SEDS-PSU/avionics/README.md

# Avionics

## /electronics
Board files and etc for avionics and teststand electronics
