SEDS-PSU/avionics/FD-Q10C.png

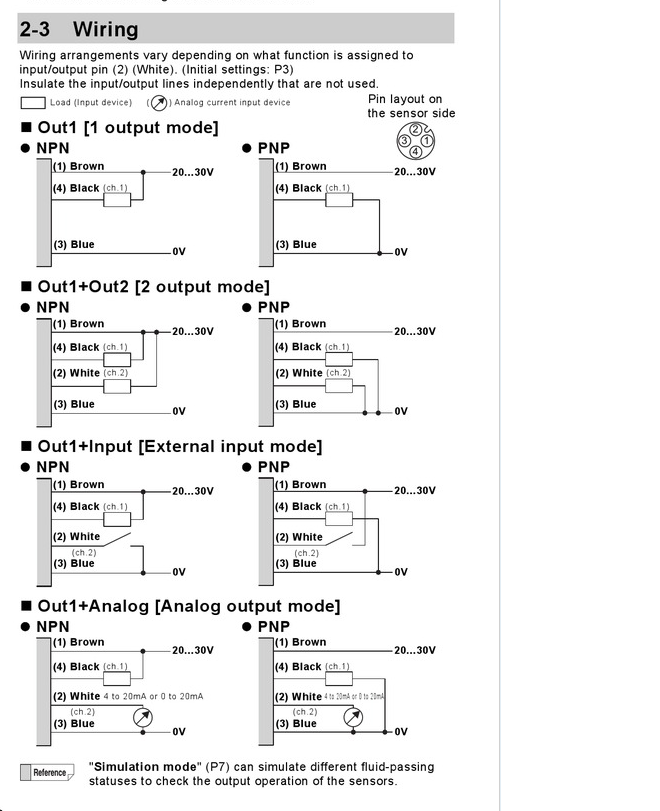
FD-Q10C.png
