SEDS-PSU/avionics/electronics/output-board/output-board BOM.xlsx

Id | Designator | Package | Quantity | Designation | Supplier and ref | Column1 | _1
1 | D1,D12,D11,D6,D7,D8,D3,D2,D5,D13,D4,D9,D10 | LED_1206_3216Metric | 13 | LED
2 | MOSFET5,MOSFET13,MOSFET18,MOSFET8,MOSFET1,MOSFET11,MOSFET2,MOSFET12,MOSFET4,MOSFET7,MOSFET9,MOSFET6,MOSFET3 | BSS806NEH6327XTSA1 | 13 | BSS806NEH6327XTSA1
3 | R5,R7,R10,R9,R4,R6,R26,R8,R20,R2,R30,R31,R28,R11 | R_0603_1608Metric | 14 | 511
4 | J8,J13,J11,J2,J7,J9,J10,J16,J15,J17,J12,J1,J18 | LatchingConnector2POS | 13 | Conn_01x02_Male
5 | C3,C1 | C_0603_1608Metric | 2 | 1uF
6 | R3 | R_0603_1608Metric | 1 | 0k
7 | Ref** | seds-logo | 1 | Val**
8 | C5,C9,C4,C6,C8,C13,C7,C12 | C_0603_1608Metric | 8 | 100nF
9 | U2 | SOT-23-5 | 1 | LD3985M33R_SOT23
10 | J6,J4 | LatchingConnector2POS | 2 | Conn_01x02
11 | J20 | LatchingConnector2POS | 1 | Ignition Detector
12 | C11,C10 | C_0603_1608Metric | 2 | 20pF
13 | Y1 | Crystal_SMD_3225-4Pin_3.2x2.5mm | 1 | 25MHz 9pF
14 | R19,R12,R21,R23,R27,R18,R29,R14,R25,R22,R16,R24,R17,R15 | R_0603_1608Metric | 14 | 1K
15 | J19 | PinHeader_2x03_P2.54mm_Vertical | 1 | Extra IO
16 | L1 | L_0603_1608Metric | 1 | 10uH
17 | SW1 | Button CS1102 | 1 | SW_Push_Dual
18 | C2 | C_0603_1608Metric | 1 | 10nF
19 | U3 | LFBGA-100_10x10mm_Layout10x10_P0.8mm | 1 | STM32F105VBH6
20 | D15 | LED_1206_3216Metric | 1 | 5V
21 | R13 | R_0603_1608Metric | 1 | 10K
22 | J14 | LatchingConnector2POS | 1 | Arming switch
23 | J3 | PowerPoleThroughHole | 1 | 12V In
24 | R32 | R_0603_1608Metric | 1 | 220
25 | MOSFET10 | BUK9Y21-40E | 1 | BUK9Y21-40E
26 | D14 | LED_1206_3216Metric | 1 | 12V
27 | U1 | MAX33012EASA+ | 1 | MAX33012EASA+
28 | R1 | R_0603_1608Metric | 1 | 10k
29 | J5 | PinHeader_1x04_P2.54mm_Vertical | 1 | SWD Header
