SEDS-PSU/avionics/electronics/datasheets/sensor-board/sensor-board BOM.xlsx

Sheet: BOM
 | Footprint | Quantity | Name
x | Button CS1102 | 1 | SW_Push_Dual |  | passive components are named with their value
 | C_0603_1608Metric | 14 | 0.1uF
 | C_0603_1608Metric | 8 | 100nF
 | C_0603_1608Metric | 1 | 10nF
 | C_0603_1608Metric | 2 | 1uF
 | C_0603_1608Metric | 2 | 20pF
 | Crystal_SMD_3225-4Pin_3.2x2.5mm | 1 | Crystal_GND24
only 1 f. | K_type_thermo_conn_F | 7 | Thermocouple PCB connector | https://evosensors.com/collections/miniature-pcb-flat-mounting/products/k1x-femx-con-fp-x-pccx
 | L_0603_1608Metric | 1 | 10uH
 | MAX33012EASA+ | 1 | 21-0041-3-M_90-0096-8L_MXM
 | 14 SO (14 pin) | 1 | MAX44252ASD
only 1 f. | MCP96RL01T_QFN | 7 | MCP96RL01T
 | PinHeader_1x04_P2.54mm_Vertical | 1 | SWD Header
order | PowerPoleThroughHole | 2 | Power Pole Connector
 | R_0603_1608Metric | 1 | 0k
 | R_0603_1608Metric | 20 | 100
 | R_0603_1608Metric | 7 | 10k
 | R_0603_1608Metric | 1 | 13k
 | R_0603_1608Metric | 22 | 150
 | R_0603_1608Metric | 7 | 1M
 | R_0603_1608Metric | 1 | 2.2k
 | R_0603_1608Metric | 1 | 22k
 | R_0603_1608Metric | 4 | 24.92
 | R_0603_1608Metric | 14 | 2M
 | R_0603_1608Metric | 1 | 4.3k
 | R_0603_1608Metric | 2 | 4.7k
 | R_0603_1608Metric | 1 | 43k
 | R_0603_1608Metric | 1 | 7.5k
 | R_0603_1608Metric | 8 | 82500 (82.5k)
x | SL_2.54_H_2pin | 15 | 2 pin molex
x | SL_2.54_H_4pin | 6 | 4 pin molex
 | SOP (14 pin) (r-pdso-g14) | 4 | LMC6036
x | SOT-23-5 | 1 | LD3985M33R_SOT23
x | STM32F105VBH6 | 1 | STM32F105VBH6

Sheet: raw_sensor-board
Id | Designator | Package | Quantity | Designation | Supplier and ref | Column1 | _1
1 | R16,R15,R20,R4,R39,R21,R6,R37,R36,R3,R22,R23,R38,R5 | R_0603_1608Metric | 14 | 2M
2 | R31 | R_0603_1608Metric | 1 | 43k
3 | R56,R61,R64,R65,R59,R55,R54,R60,R63,R51,R50,R53,R52,R57,R62,R58 | R_0603_1608Metric | 16 | NO_RES
4 | C22,C15,C18,C23,C25,C19,C26,C24,C21,C17,C20,C16,C14,C13 | C_0603_1608Metric | 14 | 0.1uF
5 | R66,R28,R29,R12,R10,R45,R110,R11,R68,R43,R70,R9,R42,R44,R18,R109,R19,R27,R26,R72 | R_0603_1608Metric | 20 | 100
6 | R24,R41,R40,R8,R7,R17,R25 | R_0603_1608Metric | 7 | 1M
7 | J6 | SL_2.54_H_2pin | 1 | Pressure_5
8 | C11,C6,C9,C8,C10,C28,C7,C29 | C_0603_1608Metric | 8 | 100nF
9 | R108,R2 | R_0603_1608Metric | 2 | 4.7k
10 | U13,U15,U12,U11 | SOP65P640X120-14N | 4 | LMC6036
11 | R91,R83,R98,R97,R92,R86,R84,R85,R95,R99,R96,R90,R94,R88,R102,R87,R103,R82,R93,R104,R89,R100 | R_0603_1608Metric | 22 | 150
12 | J29 | K_type_thermo_conn_F | 1 | Therm_6
13 | Y1 | Crystal_SMD_3225-4Pin_3.2x2.5mm | 1 | Crystal_GND24
14 | U1 | SOT-23-5 | 1 | LD3985M33R_SOT23
15 | REF**,REF**,REF**,REF**,REF** | 3mm hole | 5 | 3mm hole
16 | J19 | SL_2.54_H_2pin | 1 | Spare_1
17 | J21 | SL_2.54_H_2pin | 1 | Spare_3
18 | J31 | SL_2.54_H_4pin | 1 | Spare_HR_2
19 | R67,R71,R73,R69 | R_0603_1608Metric | 4 | 24.92
20 | SW1 | Button CS1102 | 1 | SW_Push_Dual
21 | R30,R33,R111,R46,R13,R47,R32 | R_0603_1608Metric | 7 | 10k
22 | R35 | R_0603_1608Metric | 1 | 13k
23 | R80,R77,R75,R81,R76,R74,R78,R79 | R_0603_1608Metric | 8 | 82500
24 | R48 | R_0603_1608Metric | 1 | 4.3k
25 | J30 | SL_2.54_H_4pin | 1 | Spare_HR_1
26 | J18 | SL_2.54_H_2pin | 1 | CAN_Bus
27 | TP4,TP1,TP5,TP2,TP6,TP3 | TestPoint_Pad_D2.0mm | 6 | TestPoint
28 | J23 | K_type_thermo_conn_F | 1 | Therm_1
29 | U4,U6,U5,U8,U7,U9,U10 | MCP96RL01T_QFN | 7 | MCP96RL01T
30 | C12,C27 | C_0603_1608Metric | 2 | 20pF
31 | J10 | SL_2.54_H_2pin | 1 | Suppply_5V
32 | J17 | SL_2.54_H_4pin | 1 | Flow_2
33 | J28 | K_type_thermo_conn_F | 1 | Therm_3
34 | R14 | R_0603_1608Metric | 1 | 7.5k
35 | J24 | K_type_thermo_conn_F | 1 | Therm_4
36 | J14 | SL_2.54_H_2pin | 1 | Pressure_4
37 | J1 | PinHeader_1x04_P2.54mm_Vertical | 1 | SWD Header
38 | J15 | SL_2.54_H_2pin | 1 | Pressure_9
39 | J22 | SL_2.54_H_2pin | 1 | Spare_4
40 | J8 | SL_2.54_H_2pin | 1 | Pressure_7
41 | J3 | PowerPoleThroughHole | 1 | Supply_12V
42 | J25 | K_type_thermo_conn_F | 1 | Therm_7
43 | C1,C3 | C_0603_1608Metric | 2 | 1uF
44 | L1 | L_0603_1608Metric | 1 | 10uH
45 | J5 | SL_2.54_H_4pin | 1 | Load_C_2
46 | Ref** | seds-logo | 1 | Val**
47 | J26 | K_type_thermo_conn_F | 1 | Therm_2
48 | U3 | STM32F105VBH6 | 1 | STM32F105VBH6
49 | J4 | SL_2.54_H_4pin | 1 | Load_C_1
50 | C2 | C_0603_1608Metric | 1 | 10nF
51 | J9 | SL_2.54_H_2pin | 1 | Pressure_8
52 | R34 | R_0603_1608Metric | 1 | 2.2k
53 | J7 | SL_2.54_H_2pin | 1 | Pressure_6
54 | J13 | SL_2.54_H_2pin | 1 | Pressure_3
55 | R49 | R_0603_1608Metric | 1 | 22k
56 | J12 | SL_2.54_H_2pin | 1 | Pressure_2
57 | J2 | PowerPoleThroughHole | 1 | Supply_24V
58 | J11 | SL_2.54_H_2pin | 1 | Pressure_1
59 | U2 | MAX33012EASA+ | 1 | 21-0041-3-M_90-0096-8L_MXM
60 | R112 | R_0603_1608Metric | 1 | 0k
61 | J16 | SL_2.54_H_4pin | 1 | Flow_1
62 | J27 | K_type_thermo_conn_F | 1 | Therm_5
63 | U14 | MAX44252ASD&plus_ | 1 | MAX44252ASD
64 | J20 | SL_2.54_H_2pin | 1 | Spare_2
