SEDS-PSU/avionics/electronics/sensor-board/mounting.SLDPRT

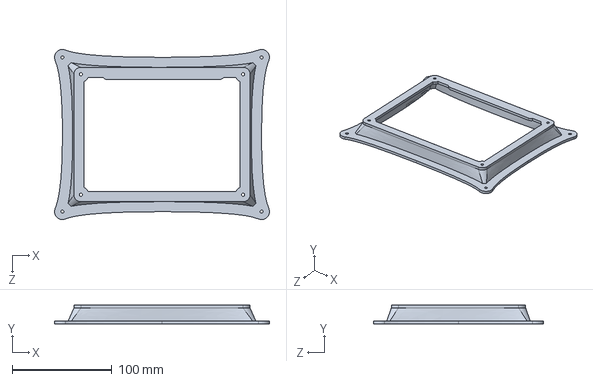
[picture p2: CAD file, 2022-04-20]
electronics/sensor-board/mounting.SLDPRT
216.0 x 19.0 x 171.0 mm
