SEDS-PSU/avionics/(list of files, cad)

Other CAD files:
electronics/sensor-board/makeProjectedPlanarWire.x_t
