SEDS-PSU/avionics/TODO.md

To Do:

MCU power supply
Safety shutoff system
General state diagram
