SEDS-PSU/avionics/electronics/output-board/Hole_locations.pdf

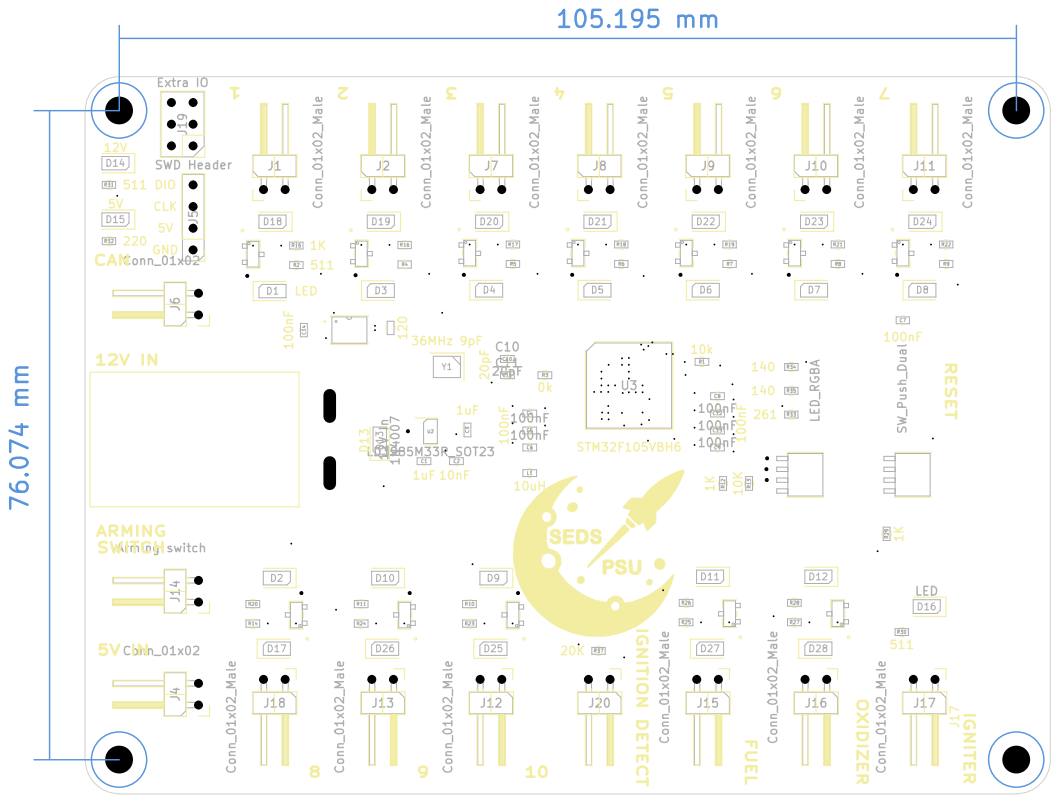
[picture p3: page 1]
