SEDS-PSU/avionics/electronics/sensor-board/hole_locations.pdf

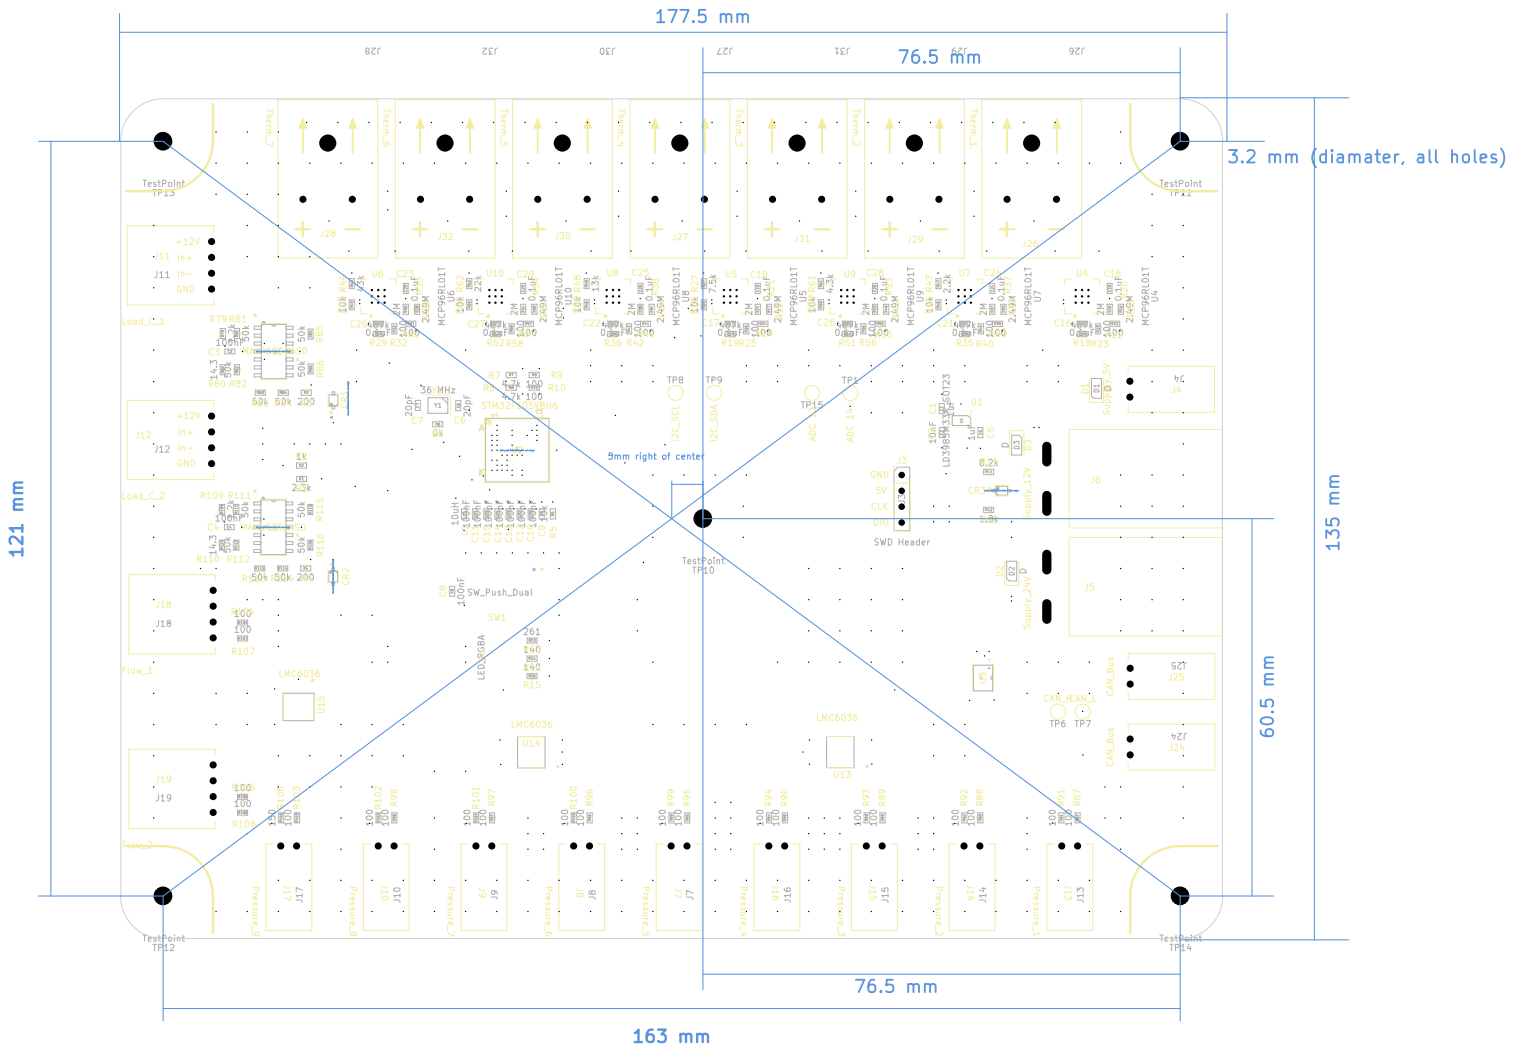
[picture p4: page 1]
