SEDS-PSU/avionics/electronics/sensor-board/sensor-board.kicad_pcb

## KiCad design electronics/sensor-board/sensor-board.kicad_pcb (2022-04-16)

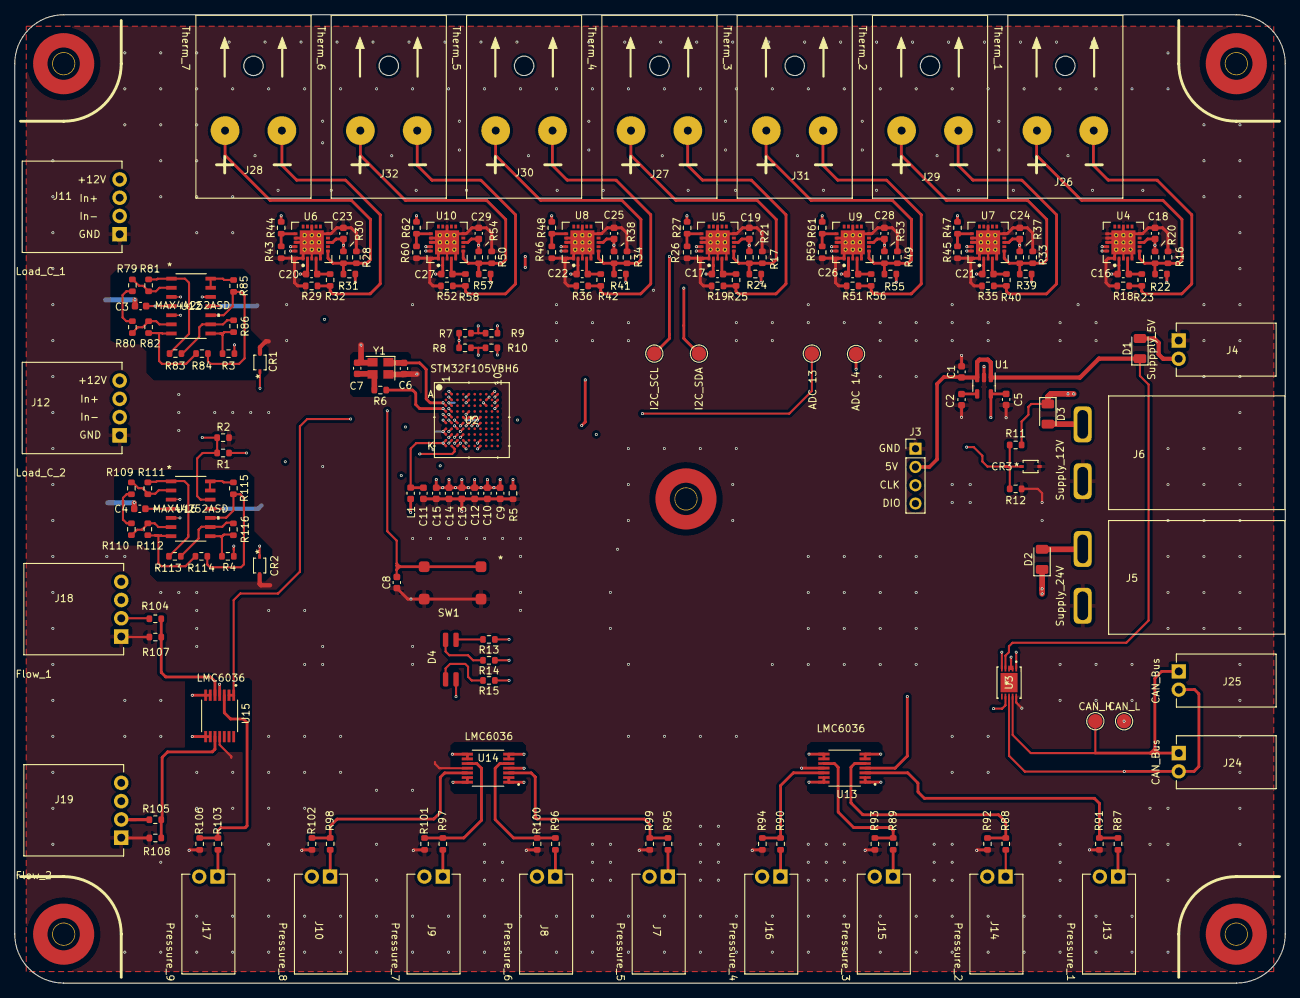
[picture p5: board electronics/sensor-board/sensor-board.kicad_pcb from above]

Board: 4 copper layers, 176.6 x 134.6 mm, 193 parts (0 on the bottom side), 126 nets.

Parts:
C1, C5: 1uF; C_0603_1608Metric
C2: 10nF; C_0603_1608Metric
C3, C4, C8, C9, C10, C11, C12, C13, C14, C15: 100nF; C_0603_1608Metric
C6, C7: 20pF; C_0603_1608Metric
C16, C17, C18, C19, C20, C21, C22, C23, C24, C25, C26, C27, C28, C29: 0.1uF; C_0603_1608Metric
CR1, CR2, CR3: MM3Z3V6C
D1, D2, D3: D; D_1206_3216Metric
D4: LED_RGBA; RGB LED
J3: SWD Header; PinHeader_1x04_P2.54mm_Vertical
J4: Suppply_5V; SL_2.54_H_2pin
J5: Supply_24V; PowerPoleThroughHole
J6: Supply_12V; PowerPoleThroughHole
J7: Pressure_5; SL_2.54_H_2pin
J8: Pressure_6; SL_2.54_H_2pin
J9: Pressure_7; SL_2.54_H_2pin
J10: Pressure_8; SL_2.54_H_2pin
J11: Load_C_1; SL_2.54_H_4pin
J12: Load_C_2; SL_2.54_H_4pin
J13: Pressure_1; SL_2.54_H_2pin
J14: Pressure_2; SL_2.54_H_2pin
J15: Pressure_3; SL_2.54_H_2pin
J16: Pressure_4; SL_2.54_H_2pin
J17: Pressure_9; SL_2.54_H_2pin
J18: Flow_1; SL_2.54_H_4pin
J19: Flow_2; SL_2.54_H_4pin
J24, J25: CAN_Bus; SL_2.54_H_2pin
J26: Therm_1; K_type_thermo_conn_F
J27: Therm_4; K_type_thermo_conn_F
J28: Therm_7; K_type_thermo_conn_F
J29: Therm_2; K_type_thermo_conn_F
J30: Therm_5; K_type_thermo_conn_F
J31: Therm_3; K_type_thermo_conn_F
J32: Therm_6; K_type_thermo_conn_F
L1: 10uH; L_0603_1608Metric
R1: 3.2k; R_0603_1608Metric
R2, R9, R10, R22, R23, R24, R25, R31, R32, R39, R40, R41, R42, R55, R56, R57, R58, R87, R88, R89, R90, R91, R92, R93, R94, R95, R96, R97, R98, R99, R100, R101, R102, R103, R104, R105, R106, R107, R108: 100; R_0603_1608Metric
R3, R4: 200; R_0603_1608Metric
R5, R26, R43, R45, R46, R59, R60: 10k; R_0603_1608Metric
R6: 0k; R_0603_1608Metric
R7, R8: 4.7k; R_0603_1608Metric
R11: 8.2k; R_0603_1608Metric
R12: 1.8k; R_0603_1608Metric
R13: 261; R_0603_1608Metric
R14, R15: 140; R_0603_1608Metric
R16, R17, R28, R33, R34, R49, R50: 2.49M; R_0603_1608Metric
R18, R19, R29, R35, R36, R51, R52: 487k; R_0603_1608Metric
R20, R21, R30, R37, R38, R53, R54: 2M; R_0603_1608Metric
R27: 7.5k; R_0603_1608Metric
R44: 43k; R_0603_1608Metric
R47: 2.2k; R_0603_1608Metric
R48: 13k; R_0603_1608Metric
R61: 4.3k; R_0603_1608Metric
R62: 22k; R_0603_1608Metric
R79, R109: 1.2k; R_0603_1608Metric
R80, R110: 14.3; R_0603_1608Metric
R81, R82, R83, R84, R85, R86, R111, R112, R113, R114, R115, R116: 50k; R_0603_1608Metric
SW1: SW_Push_Dual; Button CS1102
TP1: ADC 14; TestPoint_Pad_D2.0mm
TP2: TestPoint; seds-logo-2
TP3: TestPoint; seds-logo-back-2
TP6: CAN_H; TestPoint_Pad_D2.0mm
TP7: CAN_L; TestPoint_Pad_D2.0mm
TP8: I2C_SCL; TestPoint_Pad_D2.0mm
TP9: I2C_SDA; TestPoint_Pad_D2.0mm
TP10, TP11, TP12, TP13, TP14: TestPoint; 3mm hole
TP15: ADC 13; TestPoint_Pad_D2.0mm
U1: LD3985M33R_SOT23; SOT-23-5
U2: STM32F105VBH6
U3: MAX33014EATB+; MAX33014EATB&plus_
U4, U5, U6, U7, U8, U9, U10: MCP96RL01T; MCP96RL01T_QFN
U12, U16: MAX44252ASD; MAX44252ASD&plus_
U13, U14, U15: LMC6036; SOP65P640X120-14N
Y1: 36 MHz; Crystal_SMD_3225-4Pin_3.2x2.5mm

Connections:
+3V3: C5.1, C9.1, C10.1, C12.1, C13.1, C14.1, C15.1, C18.1, C19.1, C23.1, C24.1, C25.1, C28.1, C29.1, D4.4 (A), L1.2, R1.2, R7.1, R8.1, R20.1, R21.1, R27.2, R30.1, R37.1, R38.1, R44.2, R47.2, R48.2, R53.1, R54.1, R61.2, R62.2, U1.5 (VOUT), U2.B2 (VBAT), U2.D2 (VDD_5), U2.F4 (VDD_4), U2.F5 (VDD_3), U2.F6 (VDD_2), U2.F7 (VDD_1), U3.7 (VL), U4.8 (VDD), U5.8 (VDD), U6.8 (VDD), U7.8 (VDD), U8.8 (VDD), U9.8 (VDD), U10.8 (VDD), U13.4 (VDD), U14.4 (VDD), U15.4 (VDD)
+5V: C1.1, D1.1 (K), J3.2, U1.1 (VIN), U1.3 (INH), U3.4 (VDD)
+12V: C3.1, C4.1, D3.1 (K), J11.4, J12.4, R11.1, U12.4 (VDD), U16.4 (VDD)
+24V: D2.1 (K), J7.2, J8.2, J9.2, J10.2, J13.2, J14.2, J15.2, J16.2, J17.2, J18.4, J19.4
/ADC12_IN0: CR1.1, R3.2, U2.G2 (PA0-WKUP)
/ADC12_IN1: CR2.1, R4.2, U2.H2 (PA1)
/ADC12_IN2: U2.J2 (PA2), U14.8 (OUTC), U14.9 (INC-)
/ADC12_IN3: U2.K2 (PA3), U14.13 (IND-), U14.14 (OUTD)
/ADC12_IN4: U2.G3 (PA4), U14.1 (OUTA), U14.2 (INA-)
/ADC12_IN5: U2.H3 (PA5), U14.6 (INB-), U14.7 (OUTB)
/ADC12_IN6: U2.J3 (PA6), U13.1 (OUTA), U13.2 (INA-)
/ADC12_IN7: U2.K3 (PA7), U13.6 (INB-), U13.7 (OUTB)
/ADC12_IN8: U2.J4 (PB0), U13.8 (OUTC), U13.9 (INC-)
/ADC12_IN9: U2.K4 (PB1), U13.13 (IND-), U13.14 (OUTD)
/ADC12_IN10: U2.F1 (PC0), U15.1 (OUTA), U15.2 (INA-)
/ADC12_IN11: U2.F2 (PC1), U15.6 (INB-), U15.7 (OUTB)
/ADC12_IN12: U2.E2 (PC2), U15.8 (OUTC), U15.9 (INC-)
/ADC12_IN13: TP15.1, U2.F3 (PC3)
/ADC12_IN14: TP1.1, U2.G4 (PC4)
/ADC12_IN15: CR3.1, R11.2, R12.1, U2.H4 (PC5)
/CAN_RX: U2.C10 (PA11), U3.5 (RXD)
/CAN_TX: U2.B10 (PA12), U3.1 (TXD)
/I2C1_SCL: R7.2, R9.1, TP8.1, U4.19 (SCL), U5.19 (SCL), U6.19 (SCL), U7.19 (SCL), U8.19 (SCL), U9.19 (SCL), U10.19 (SCL)
/I2C1_SDA: R8.2, R10.1, TP9.1, U4.20 (SDA), U5.20 (SDA), U6.20 (SDA), U7.20 (SDA), U8.20 (SDA), U9.20 (SDA), U10.20 (SDA)
/Load Cell 1/In+: J11.3, U12.5 (INB+)
/Load Cell 1/In-: J11.2, U12.3 (INA+)
/Load Cell 1/out: R3.1, R86.2, U12.8 (OUTC)
/Load Cell 2/In+: J12.3, U16.5 (INB+)
/Load Cell 2/In-: J12.2, U16.3 (INA+)
/Load Cell 2/out: R4.1, R116.2, U16.8 (OUTC)
/Pressure 1/diff+A: J13.1, R87.2
/Pressure 1/diff+B: J14.1, R88.2
/Pressure 1/diff+C: J15.1, R89.2
/Pressure 1/diff+D: J16.1, R90.2
/Pressure 2/diff+A: J7.1, R95.2
/Pressure 2/diff+B: J8.1, R96.2
/Pressure 2/diff+C: J9.1, R97.2
/Pressure 2/diff+D: J10.1, R98.2
/Pressure and Flow/diff+A: J17.1, R103.2
/Pressure and Flow/diff+B: J18.2, R104.2
/Pressure and Flow/diff+C: J19.2, R105.2
/SWCLK: J3.3, U2.A9 (PA14)
/SWDIO: J3.4, U2.A10 (PA13)
/Vref: R1.1, R2.2, U12.12 (IND+), U16.12 (IND+)
GND: C1.2, C2.2, C3.2, C4.2, C5.2, C6.1, C7.1, C8.1, C9.2, C10.2, C11.2, C12.2, C13.2, C14.2, C15.2, C18.2, C19.2, C23.2, C24.2, C25.2, C28.2, C29.2, CR1.2, CR2.2, CR3.2, J3.1, J4.1, J5.1, J6.1, J11.1, J12.1, J18.1, J19.1, R2.1, R5.2, R12.2, R16.2, R17.2, R18.2, R19.2, R26.2, R28.2, R29.2, R33.2, R34.2, R35.2, R36.2, R43.2, R45.2, R46.2, R49.2, R50.2, R51.2, R52.2, R59.2, R60.2, R91.2, R92.2, R93.2, R94.2, R99.2, R100.2, R101.2, R102.2, R106.2, R107.2, R108.2, SW1.1, SW1.3, U1.2 (GND), U2.C2 (VSS_5), U2.E4 (VSS_4), U2.E5 (VSS_3), U2.E6 (VSS_2), U2.E7 (VSS_1), U2.G1 (VSSA), U2.H1 (VREF-), U3.2 (LPBK), U3.3 (GND), U3.10 (STBY), U4.1 (GND), U4.3 (GND), U4.5 (GND), U4.10 (GND), U4.13 (GND), U4.16 (ADDR), U4.17 (GND), U4.18 (GND), U4.21 (Body_(gnd)), U5.1 (GND), U5.3 (GND), U5.5 (GND), U5.10 (GND), U5.13 (GND), U5.17 (GND), U5.18 (GND), U5.21 (Body_(gnd)), U6.1 (GND), U6.3 (GND), U6.5 (GND), U6.10 (GND), U6.13 (GND), U6.17 (GND), U6.18 (GND), U6.21 (Body_(gnd)), U7.1 (GND), U7.3 (GND), U7.5 (GND), U7.10 (GND), U7.13 (GND), U7.17 (GND), U7.18 (GND), U7.21 (Body_(gnd)), U8.1 (GND), U8.3 (GND), U8.5 (GND), U8.10 (GND), U8.13 (GND), U8.17 (GND), U8.18 (GND), U8.21 (Body_(gnd)), U9.1 (GND), U9.3 (GND), U9.5 (GND), U9.10 (GND), U9.13 (GND), U9.17 (GND), U9.18 (GND), U9.21 (Body_(gnd)), U10.1 (GND), U10.3 (GND), U10.5 (GND), U10.10 (GND), U10.13 (GND), U10.17 (GND), U10.18 (GND), U10.21 (Body_(gnd)), U12.11 (VSS), U13.11 (VSS), U14.11 (VSS), U15.11 (VSS), U16.11 (VSS), Y1.2, Y1.4
unnamed: C2.1, U1.4 (BYP)
unnamed: C6.2, U2.C1 (OSC_IN), Y1.1
unnamed: C7.2, R6.1, Y1.3
unnamed: C8.2, SW1.2, SW1.4, U2.E1 (NRST)
unnamed: C16.1, R22.2, U4.2 (VIN+)
unnamed: C16.2, R23.2, U4.4 (VIN-)
unnamed: C17.1, R24.2, U5.2 (VIN+)
unnamed: C17.2, R25.2, U5.4 (VIN-)
unnamed: C20.1, R31.2, U6.2 (VIN+)
unnamed: C20.2, R32.2, U6.4 (VIN-)
unnamed: C21.1, R39.2, U7.2 (VIN+)
unnamed: C21.2, R40.2, U7.4 (VIN-)
unnamed: C22.1, R41.2, U8.2 (VIN+)
unnamed: C22.2, R42.2, U8.4 (VIN-)
unnamed: C26.1, R55.2, U9.2 (VIN+)
unnamed: C26.2, R56.2, U9.4 (VIN-)
unnamed: C27.1, R57.2, U10.2 (VIN+)
unnamed: C27.2, R58.2, U10.4 (VIN-)
unnamed: D1.2 (A), J4.2
unnamed: D2.2 (A), J5.2
unnamed: D3.2 (A), J6.2
unnamed: D4.1 (RK), R13.2
unnamed: D4.2 (GK), R14.2
unnamed: D4.3 (BK), R15.2
unnamed: J24.1, J25.1, TP6.1, U3.9 (CANH)
unnamed: J24.2, J25.2, TP7.1, U3.8 (CANL)
unnamed: J26.1, R16.1, R20.2, R22.1, U4.6 (VSENSE)
unnamed: J26.2, R18.1, R23.1
unnamed: J27.1, R17.1, R21.2, R24.1, U5.6 (VSENSE)
unnamed: J27.2, R19.1, R25.1
unnamed: J28.1, R28.1, R30.2, R31.1, U6.6 (VSENSE)
unnamed: J28.2, R29.1, R32.1
unnamed: J29.1, R33.1, R37.2, R39.1, U7.6 (VSENSE)
unnamed: J29.2, R35.1, R40.1
unnamed: J30.1, R34.1, R38.2, R41.1, U8.6 (VSENSE)
unnamed: J30.2, R36.1, R42.1
unnamed: J31.1, R49.1, R53.2, R55.1, U9.6 (VSENSE)
unnamed: J31.2, R51.1, R56.1
unnamed: J32.1, R50.1, R54.2, R57.1, U10.6 (VSENSE)
unnamed: J32.2, R52.1, R58.1
unnamed: R5.1, U2.D5 (BOOT0)
unnamed: R6.2, U2.D1 (OSC_OUT)
unnamed: R9.2, U2.B5 (PB6)
unnamed: R10.2, U2.A5 (PB7)
unnamed: R13.1, U2.B8 (PC11)
unnamed: R14.1, U2.C8 (PC12)
unnamed: R15.1, U2.A2 (PC13)
unnamed: R26.1, R27.1, U5.16 (ADDR)
unnamed: R43.1, R44.1, U6.16 (ADDR)
unnamed: R45.1, R47.1, U7.16 (ADDR)
unnamed: R46.1, R48.1, U8.16 (ADDR)
unnamed: R59.1, R61.1, U9.16 (ADDR)
unnamed: R60.1, R62.1, U10.16 (ADDR)
unnamed: R79.1, R80.1
unnamed: R79.2, R81.1, U12.2 (INA-)
unnamed: R80.2, R82.1, U12.6 (INB-)
unnamed: R81.2, R83.1, U12.1 (OUTA)
unnamed: R82.2, R84.1, U12.7 (OUTB)
unnamed: R83.2, R86.1, U12.9 (INC-)
unnamed: R84.2, R85.2, U12.10 (INC+)
unnamed: R85.1, U12.13 (IND-), U12.14 (OUTD)
unnamed: R87.1, R91.1, U13.3 (INA+)
unnamed: R88.1, R92.1, U13.5 (INB+)
unnamed: R89.1, R93.1, U13.10 (INC+)
unnamed: R90.1, R94.1, U13.12 (IND+)
unnamed: R95.1, R99.1, U14.3 (INA+)
unnamed: R96.1, R100.1, U14.5 (INB+)
unnamed: R97.1, R101.1, U14.10 (INC+)
unnamed: R98.1, R102.1, U14.12 (IND+)
unnamed: R103.1, R106.1, U15.3 (INA+)
unnamed: R104.1, R107.1, U15.5 (INB+)
unnamed: R105.1, R108.1, U15.10 (INC+)
unnamed: R109.1, R110.1
unnamed: R109.2, R111.1, U16.2 (INA-)
unnamed: R110.2, R112.1, U16.6 (INB-)
unnamed: R111.2, R113.1, U16.1 (OUTA)
unnamed: R112.2, R114.1, U16.7 (OUTB)
unnamed: R113.2, R116.1, U16.9 (INC-)
unnamed: R114.2, R115.2, U16.10 (INC+)
unnamed: R115.1, U16.13 (IND-), U16.14 (OUTD)
VDDA: C11.1, L1.1, U2.J1 (VREF+), U2.K1 (VDDA)
