SEDS-PSU/avionics/electronics/raspi-hat/raspi-hat.kicad_pcb

## KiCad design electronics/raspi-hat/raspi-hat.kicad_pcb (2022-04-03)

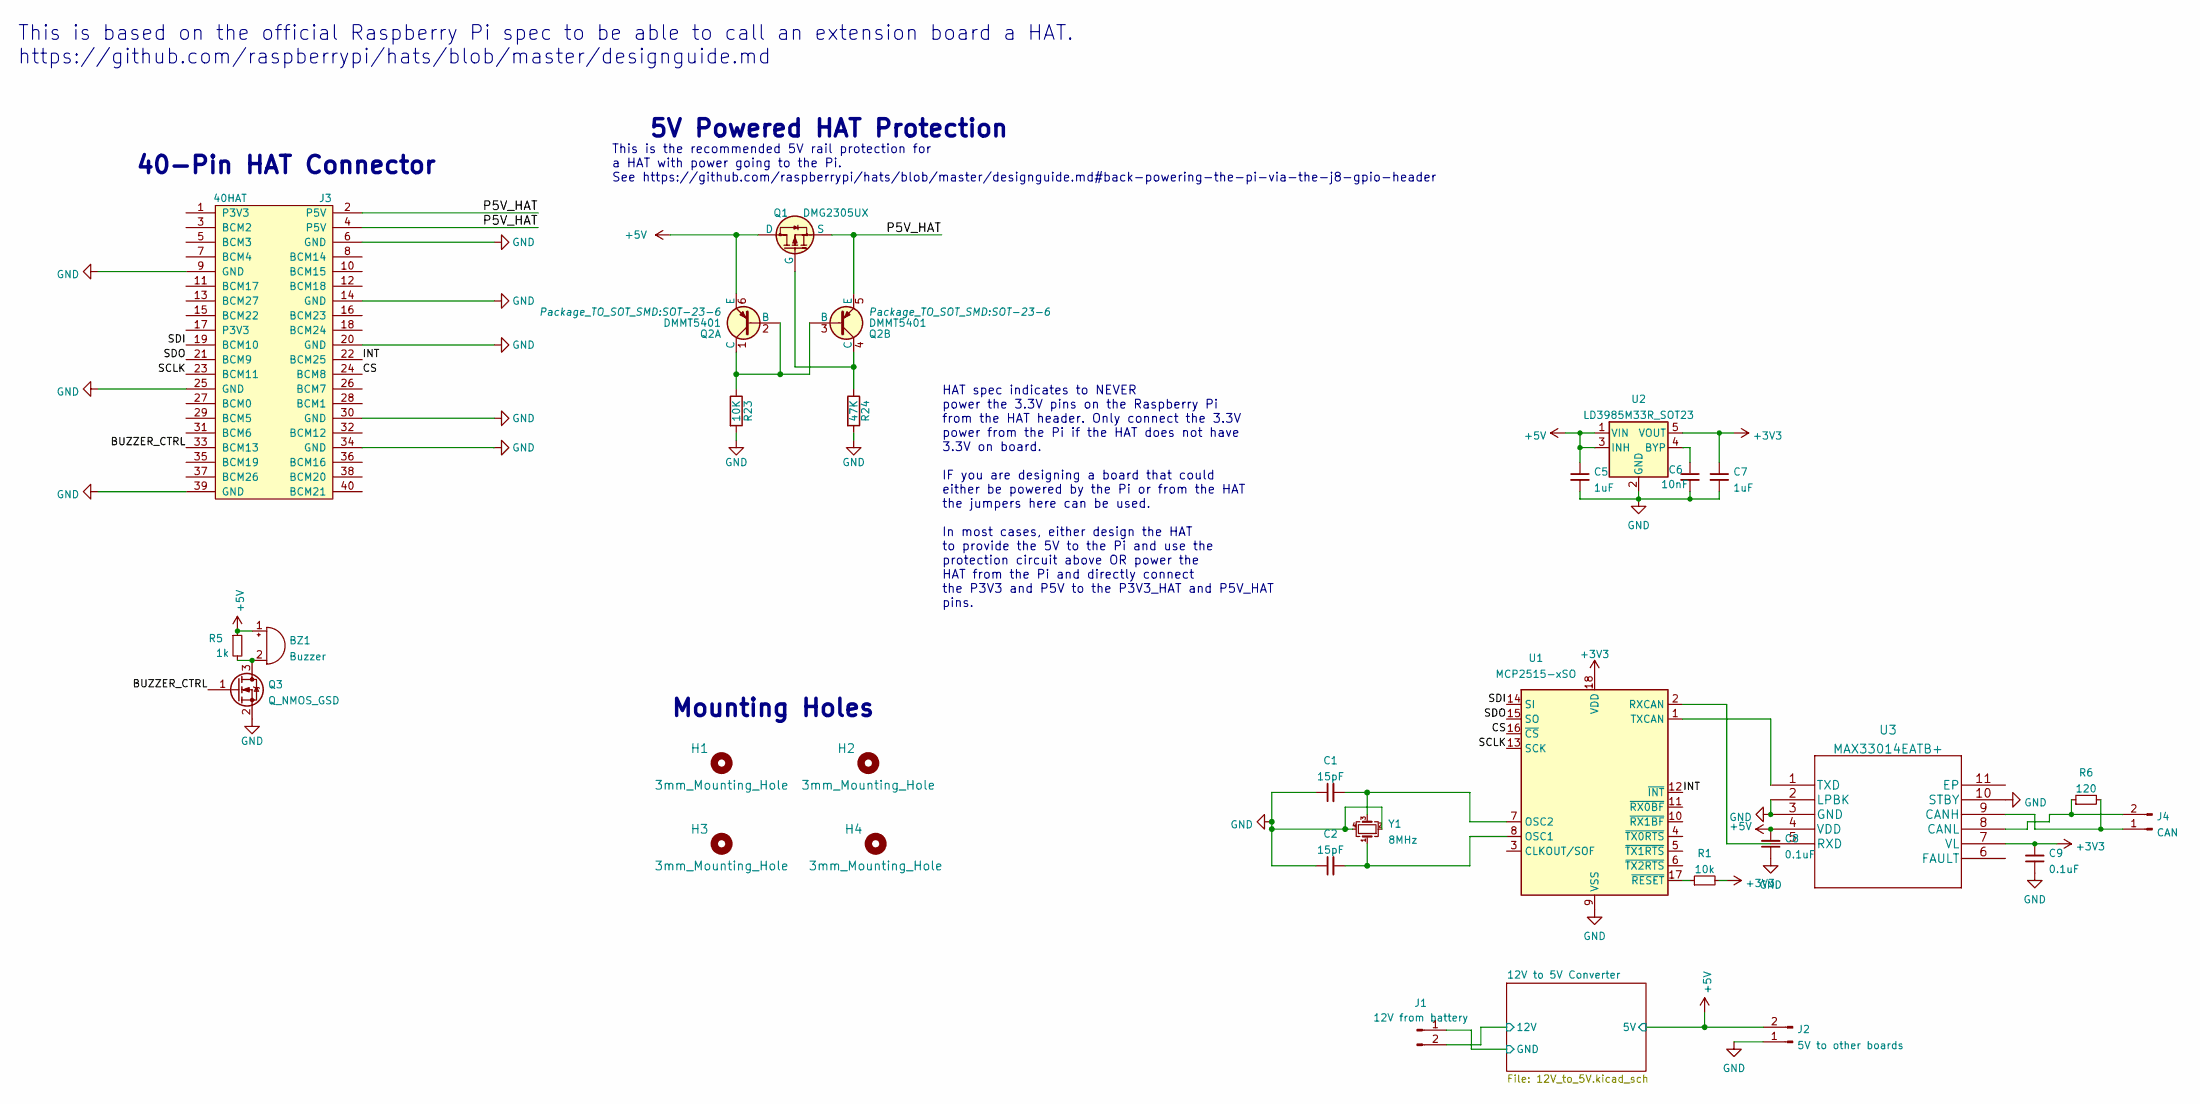
[picture p6: schematic raspi-hat.kicad_sch, Raspberry Pi HAT]

Parts:
BZ1: Buzzer; PS1420P02CT
C1, C2: 15pF; C_0603_1608Metric
C5, C7: 1uF; C_0603_1608Metric
C6: 10nF; C_0603_1608Metric
C8, C9: 0.1uF; C_0603_1608Metric
H1, H2, H3, H4: 3mm_Mounting_Hole; NPTH_3mm_ID
J1: 12V from battery; PowerPoleThroughHole
J2: 5V to other boards; LatchingConnector2POS
J3: 40HAT; PinSocket_2x20_P2.54mm_Vertical
J4: CAN; LatchingConnector2POS
Q1: DMG2305UX; SOT-23
Q2: DMMT5401; SOT-23-6
Q3: Q_NMOS_GSD; SOT-23
R1: 10k; R_0603_1608Metric
R5: 1k; R_0603_1608Metric
R6: 120; R_0603_1608Metric
R23: 10K; R_0603_1608Metric_Pad0.84x1.00mm_HandSolder
R24: 47K; R_0603_1608Metric_Pad0.84x1.00mm_HandSolder
U1: MCP2515-xSO; SOIC-18W_7.5x11.6mm_P1.27mm
U2: LD3985M33R_SOT23; SOT-23-5
U3: MAX33014EATB+; MAX33014EATB&plus_
Y1: 8MHz; Crystal_SMD_3225-4Pin_3.2x2.5mm

Connections:
+3V3: C7.1, C9.2, R1.2, U1.18 (VDD), U2.5 (VOUT), U3.7 (VL)
+5V: BZ1.1 (-), C5.1, C8.2, J2.2, Q1.3 (D), Q2.6 (E), R5.1, U2.1 (VIN), U2.3 (INH), U3.4 (VDD); also elsewhere on the board
+12V: J1.2; also elsewhere on the board
/BUZZER_CTRL: J3.33 (BCM13), Q3.1 (G)
/CS: J3.24 (BCM8), U1.16 (~CS)
/INT: J3.22 (BCM25), U1.12 (~INT)
/P5V_HAT: J3.2 (P5V), J3.4 (P5V), Q1.2 (S), Q2.5 (E)
/SCLK: J3.23 (BCM11), U1.13 (SCK)
/SDI: J3.19 (BCM10), U1.14 (SI)
/SDO: J3.21 (BCM9), U1.15 (SO)
GND: C1.1, C2.1, C5.2, C6.2, C7.2, C8.1, C9.1, J1.1, J2.1, J3.6 (GND), J3.9 (GND), J3.14 (GND), J3.20 (GND), J3.25 (GND), J3.30 (GND), J3.34 (GND), J3.39 (GND), Q3.2 (S), R23.2, R24.2, U1.9 (VSS), U2.2 (GND), U3.2 (LPBK), U3.3 (GND), U3.10 (STBY), Y1.2, Y1.4; also elsewhere on the board
unnamed: BZ1.2 (+), Q3.3 (D), R5.2
unnamed: C1.2, U1.7 (OSC2), Y1.3
unnamed: C2.2, U1.8 (OSC1), Y1.1
unnamed: C6.1, U2.4 (BYP)
unnamed: J4.1, R6.2, U3.9 (CANH)
unnamed: J4.2, R6.1, U3.8 (CANL)
unnamed: Q1.1 (G), Q2.4 (C), R24.1
unnamed: Q2.1 (C), Q2.2 (B), Q2.3 (B), R23.1
unnamed: R1.1, U1.17 (~RESET)
unnamed: U1.1 (TXCAN), U3.1 (TXD)
unnamed: U1.2 (RXCAN), U3.5 (RXD)

Notes on the sheet:
This is based on the official Raspberry Pi spec to be able to call an extension board a HAT. https://github.com/raspberrypi/hats/blob/master/designguide.md
This is the recommended 5V rail protection for a HAT with power going to the Pi. See https://github.com/raspberrypi/hats/blob/master/designguide.md#back-powering-the-pi-via-the-j8-gpio-header
5V Powered HAT Protection
HAT spec indicates to NEVER power the 3.3V pins on the Raspberry Pi from the HAT header. Only connect the 3.3V power from the Pi if the HAT does not have 3.3V on board. IF you are designing a board that could either be powered by the Pi or from the HAT the jumpers here can be used. In most cases, e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
40-Pin HAT Connector
Mounting Holes

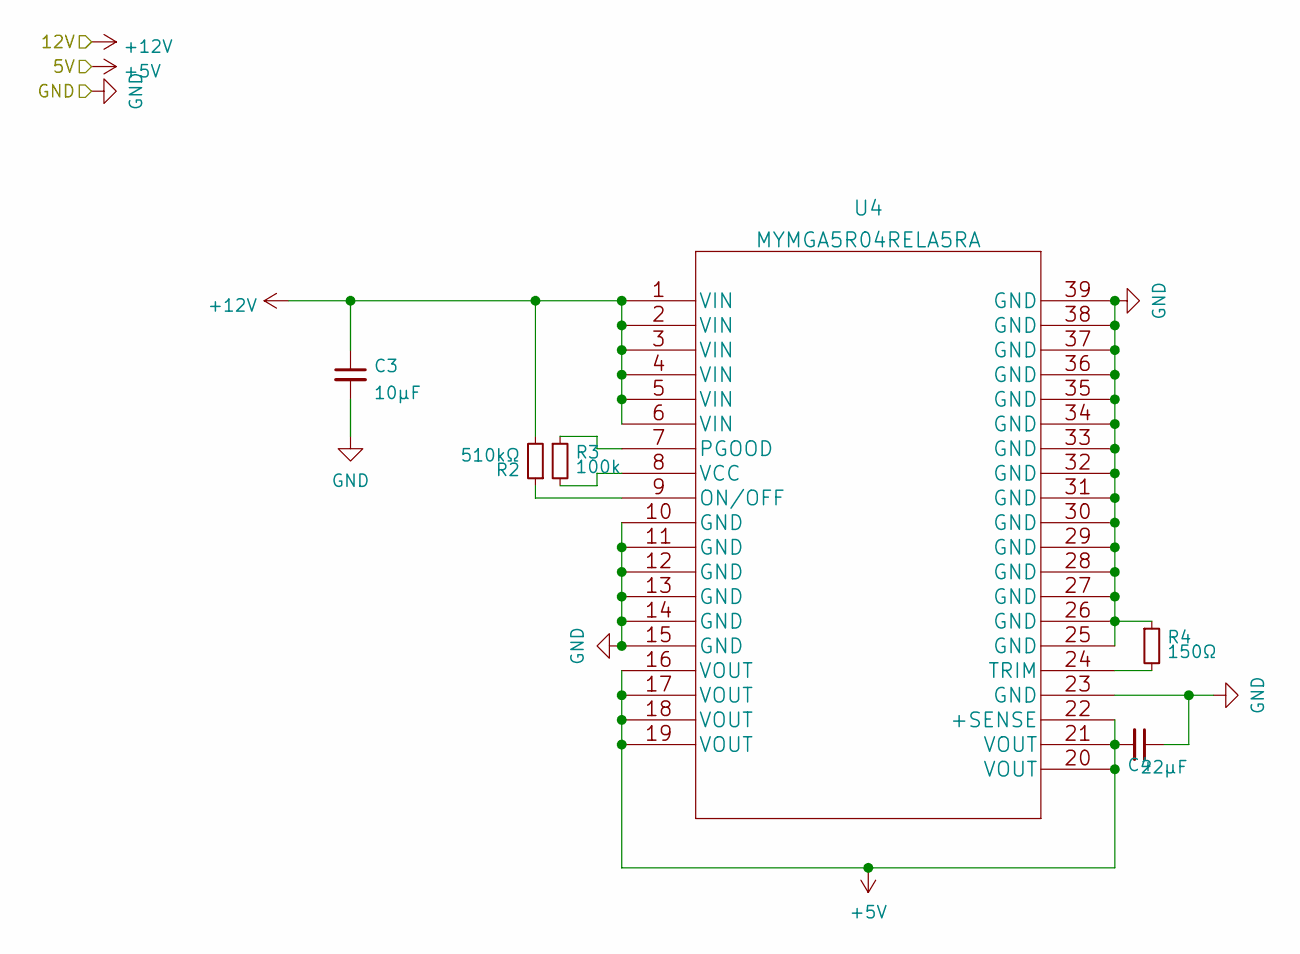
[picture p7: schematic 12V_to_5V.kicad_sch]

Parts:
C3: 10μF; C_0603_1608Metric
C4: 22μF; C_0603_1608Metric
R2: 510kΩ; R_0603_1608Metric
R3: 100k; R_0603_1608Metric
R4: 150Ω; R_0603_1608Metric
U4: MYMGA5R04RELA5RA

Connections:
+5V: C4.2, U4.16 (VOUT), U4.17 (VOUT), U4.18 (VOUT), U4.19 (VOUT), U4.20 (VOUT), U4.21 (VOUT), U4.22 (+SENSE); also elsewhere on the board
+12V: C3.1, R2.2, U4.1 (VIN), U4.2 (VIN), U4.3 (VIN), U4.4 (VIN), U4.5 (VIN), U4.6 (VIN); also elsewhere on the board
GND: C3.2, C4.1, R4.1, U4.10 (GND), U4.11 (GND), U4.12 (GND), U4.13 (GND), U4.14 (GND), U4.15 (GND), U4.23 (GND), U4.25 (GND), U4.26 (GND), U4.27 (GND), U4.28 (GND), U4.29 (GND), U4.30 (GND), U4.31 (GND), U4.32 (GND), U4.33 (GND), U4.34 (GND), U4.35 (GND), U4.36 (GND), U4.37 (GND), U4.38 (GND), U4.39 (GND); also elsewhere on the board
unnamed: R2.1, U4.9 (ON/OFF)
unnamed: R3.1, U4.7 (PGOOD)
unnamed: R3.2, U4.8 (VCC)
unnamed: R4.2, U4.24 (TRIM)

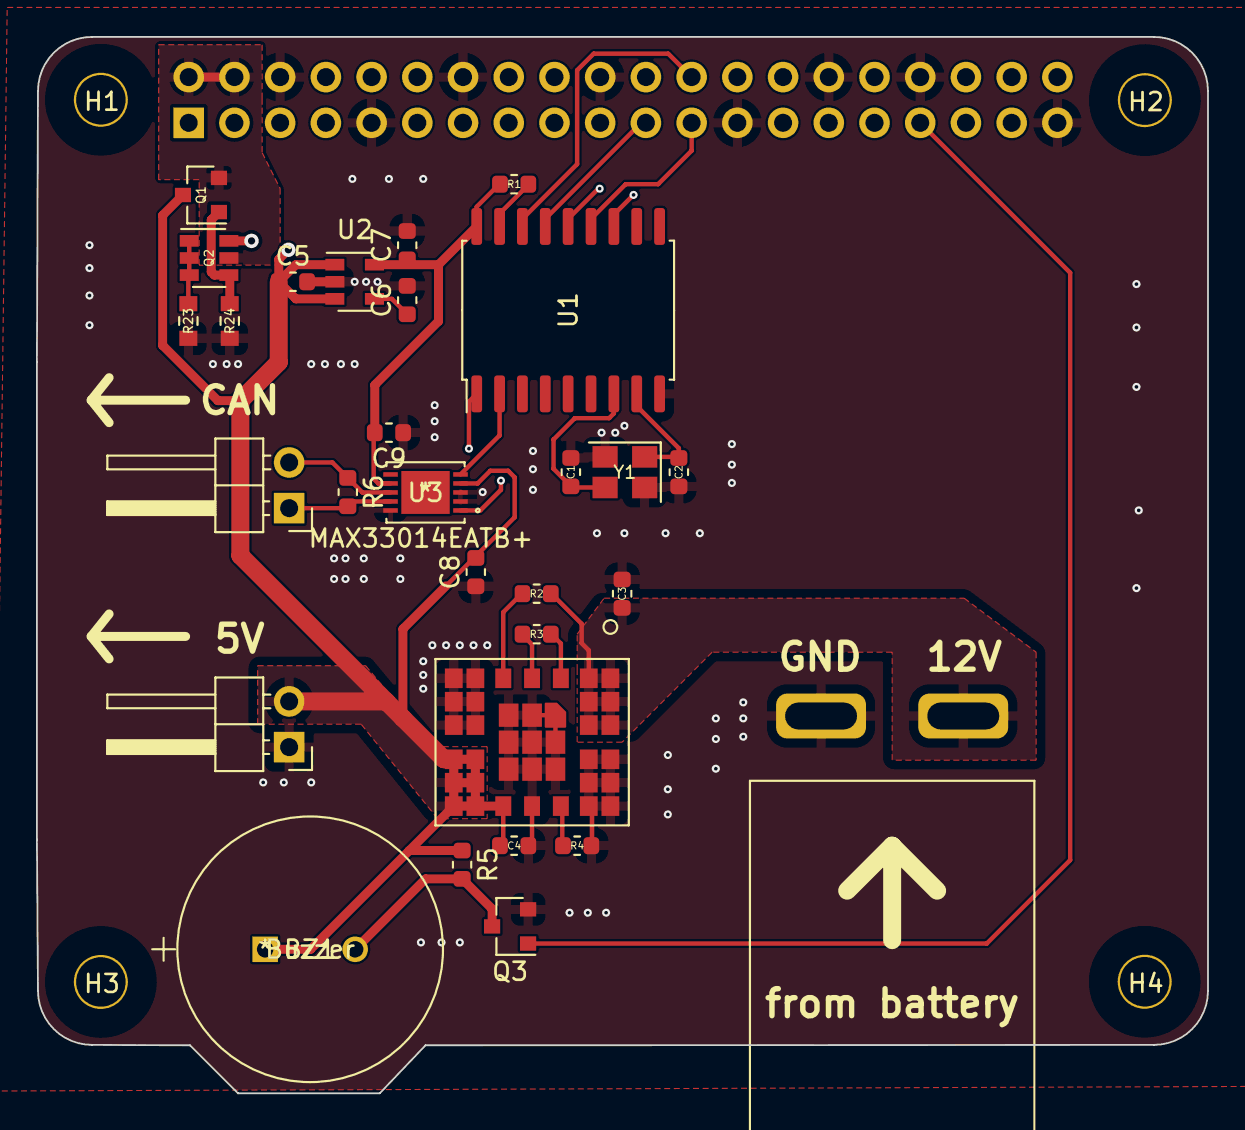
[picture p8: board raspi-hat.kicad_pcb from above]

Board: 4 copper layers, 65.1 x 58.7 mm, 34 parts (1 on the bottom side), 26 nets.
