SEDS-PSU/avionics/electronics/datasheets/sensor-board/sensor-board.kicad_pcb

## KiCad design electronics/datasheets/sensor-board/sensor-board.kicad_pcb (2022-01-11)

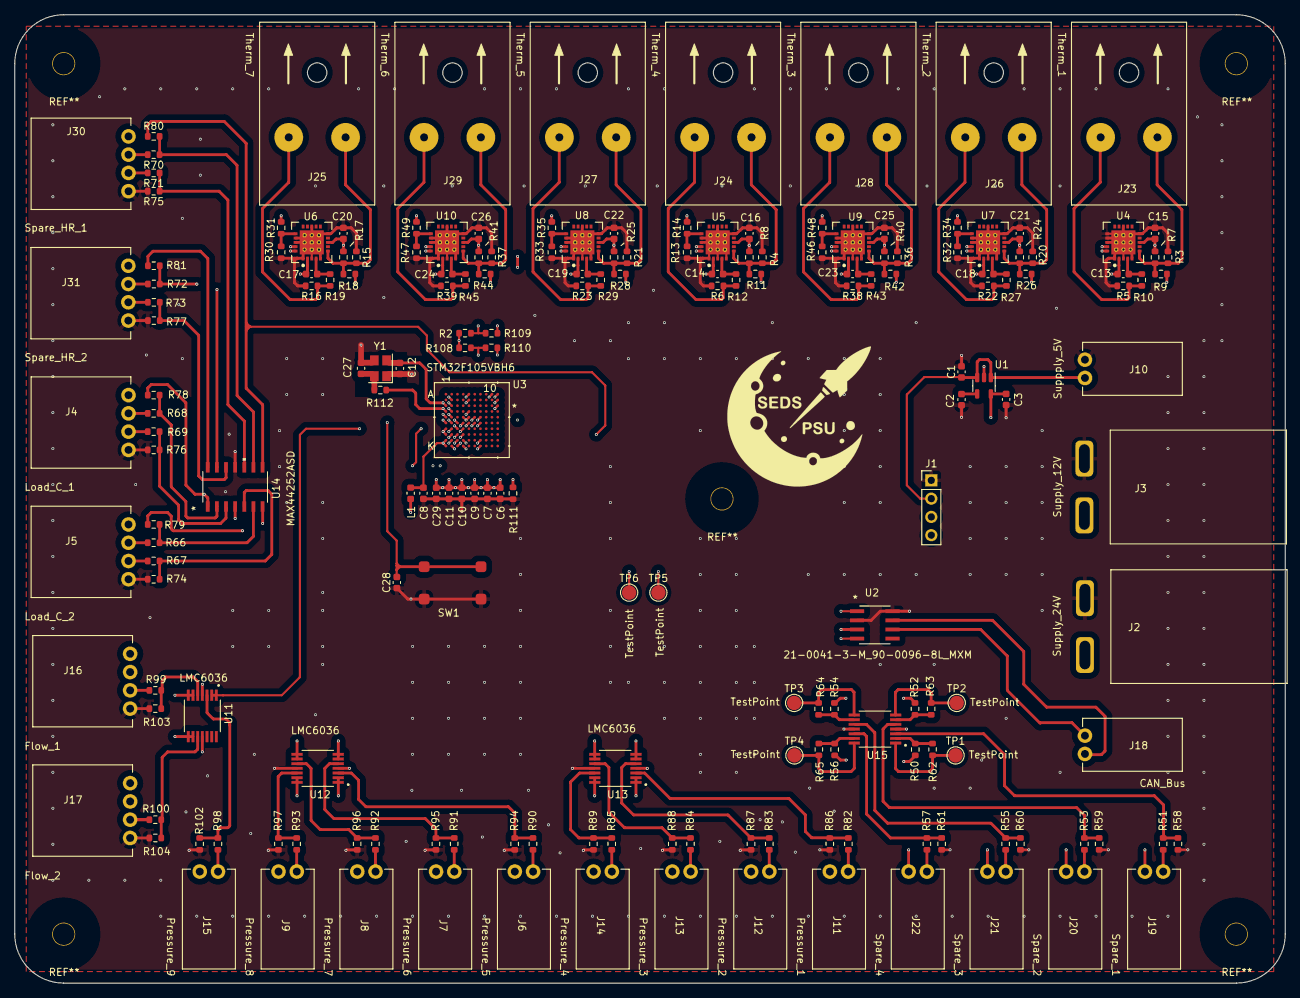
[picture p9: board electronics/datasheets/sensor-board/sensor-board.kicad_pcb from above]

Board: 4 copper layers, 176.6 x 134.6 mm, 190 parts (0 on the bottom side), 131 nets.

Parts:
C1, C3: 1uF; C_0603_1608Metric
C2: 10nF; C_0603_1608Metric
C6, C7, C8, C9, C10, C11, C28, C29: 100nF; C_0603_1608Metric
C12, C27: 20pF; C_0603_1608Metric
C13, C14, C15, C16, C17, C18, C19, C20, C21, C22, C23, C24, C25, C26: 0.1uF; C_0603_1608Metric
J1: SWD Header; PinHeader_1x04_P2.54mm_Vertical
J2: Supply_24V; PowerPoleThroughHole
J3: Supply_12V; PowerPoleThroughHole
J4: Load_C_1; SL_2.54_H_4pin
J5: Load_C_2; SL_2.54_H_4pin
J6: Pressure_5; SL_2.54_H_2pin
J7: Pressure_6; SL_2.54_H_2pin
J8: Pressure_7; SL_2.54_H_2pin
J9: Pressure_8; SL_2.54_H_2pin
J10: Suppply_5V; SL_2.54_H_2pin
J11: Pressure_1; SL_2.54_H_2pin
J12: Pressure_2; SL_2.54_H_2pin
J13: Pressure_3; SL_2.54_H_2pin
J14: Pressure_4; SL_2.54_H_2pin
J15: Pressure_9; SL_2.54_H_2pin
J16: Flow_1; SL_2.54_H_4pin
J17: Flow_2; SL_2.54_H_4pin
J18: CAN_Bus; SL_2.54_H_2pin
J19: Spare_1; SL_2.54_H_2pin
J20: Spare_2; SL_2.54_H_2pin
J21: Spare_3; SL_2.54_H_2pin
J22: Spare_4; SL_2.54_H_2pin
J23: Therm_1; K_type_thermo_conn_F
J24: Therm_4; K_type_thermo_conn_F
J25: Therm_7; K_type_thermo_conn_F
J26: Therm_2; K_type_thermo_conn_F
J27: Therm_5; K_type_thermo_conn_F
J28: Therm_3; K_type_thermo_conn_F
J29: Therm_6; K_type_thermo_conn_F
J30: Spare_HR_1; SL_2.54_H_4pin
J31: Spare_HR_2; SL_2.54_H_4pin
L1: 10uH; L_0603_1608Metric
R2, R108: 4.7k; R_0603_1608Metric
R3, R4, R5, R6, R15, R16, R20, R21, R22, R23, R36, R37, R38, R39: 2M; R_0603_1608Metric
R7, R8, R17, R24, R25, R40, R41: 1M; R_0603_1608Metric
R9, R10, R11, R12, R18, R19, R26, R27, R28, R29, R42, R43, R44, R45, R66, R68, R70, R72, R109, R110: 100; R_0603_1608Metric
R13, R30, R32, R33, R46, R47, R111: 10k; R_0603_1608Metric
R14: 7.5k; R_0603_1608Metric
R31: 43k; R_0603_1608Metric
R34: 2.2k; R_0603_1608Metric
R35: 13k; R_0603_1608Metric
R48: 4.3k; R_0603_1608Metric
R49: 22k; R_0603_1608Metric
R50, R51, R52, R53, R54, R55, R56, R57, R58, R59, R60, R61, R62, R63, R64, R65: NO_RES; R_0603_1608Metric
R67, R69, R71, R73: 24.92; R_0603_1608Metric
R74, R75, R76, R77, R78, R79, R80, R81: 82500; R_0603_1608Metric
R82, R83, R84, R85, R86, R87, R88, R89, R90, R91, R92, R93, R94, R95, R96, R97, R98, R99, R100, R102, R103, R104: 150; R_0603_1608Metric
R112: 0k; R_0603_1608Metric
Ref**: Val**; seds-logo
SW1: SW_Push_Dual; Button CS1102
TP1, TP2, TP3, TP4, TP5, TP6: TestPoint; TestPoint_Pad_D2.0mm
U1: LD3985M33R_SOT23; SOT-23-5
U2: 21-0041-3-M_90-0096-8L_MXM; MAX33012EASA+
U3: STM32F105VBH6
U4, U5, U6, U7, U8, U9, U10: MCP96RL01T; MCP96RL01T_QFN
U11, U12, U13, U15: LMC6036; SOP65P640X120-14N
U14: MAX44252ASD; MAX44252ASD&plus_
Y1: Crystal_GND24; Crystal_SMD_3225-4Pin_3.2x2.5mm

Connections:
+3V3: C3.1, C6.1, C7.1, C9.1, C10.1, C11.1, C15.1, C16.1, C20.1, C21.1, C22.1, C25.1, C26.1, C29.1, L1.2, R2.1, R7.1, R8.1, R14.2, R17.1, R24.1, R25.1, R31.2, R34.2, R35.2, R40.1, R41.1, R48.2, R49.2, R108.1, U1.5 (VOUT), U2.3 (VDD), U3.B2 (VBAT), U3.D2 (VDD_5), U3.F4 (VDD_4), U3.F5 (VDD_3), U3.F6 (VDD_2), U3.F7 (VDD_1), U4.8 (VDD), U5.8 (VDD), U6.8 (VDD), U7.8 (VDD), U8.8 (VDD), U9.8 (VDD), U10.8 (VDD), U11.4 (VDD), U12.4 (VDD), U13.4 (VDD), U14.4 (VDD), U15.4 (VDD)
+5V: C1.1, J1.2, J10.1, U1.1 (VIN), U1.3 (INH)
+12V: J3.1, J4.1, J5.1, J6.1, J7.1, J8.1, J9.1, J11.1, J12.1, J13.1, J14.1, J15.1, J30.1, J31.1
+24V: J2.1, J16.1, J17.1
/ADC12_IN0: R78.1, U3.G2 (PA0-WKUP), U14.1 (OUTA)
/ADC12_IN1: R79.1, U3.H2 (PA1), U14.7 (OUTB)
/ADC12_IN2: U3.J2 (PA2), U12.8 (OUTC), U12.9 (INC-)
/ADC12_IN3: U3.K2 (PA3), U12.13 (IND-), U12.14 (OUTD)
/ADC12_IN4: U3.G3 (PA4), U12.1 (OUTA), U12.2 (INA-)
/ADC12_IN5: U3.H3 (PA5), U12.6 (INB-), U12.7 (OUTB)
/ADC12_IN6: U3.J3 (PA6), U13.1 (OUTA), U13.2 (INA-)
/ADC12_IN7: U3.K3 (PA7), U13.6 (INB-), U13.7 (OUTB)
/ADC12_IN8: U3.J4 (PB0), U13.8 (OUTC), U13.9 (INC-)
/ADC12_IN9: U3.K4 (PB1), U13.13 (IND-), U13.14 (OUTD)
/ADC12_IN10: U3.F1 (PC0), U11.1 (OUTA), U11.2 (INA-)
/ADC12_IN11: U3.F2 (PC1), U11.6 (INB-), U11.7 (OUTB)
/ADC12_IN12: U3.E2 (PC2), U11.8 (OUTC), U11.9 (INC-)
/ADC12_IN13: TP5.1, U3.F3 (PC3)
/ADC12_IN14: TP6.1, U3.G4 (PC4)
/ADC12_IN15: R80.1, U3.H4 (PC5), U14.8 (OUTC)
/CAN_RX: U2.4 (RXD), U3.C10 (PA11)
/CAN_TX: U2.1 (TXD), U3.B10 (PA12)
/I2C1_SCL: R2.2, R109.1, U4.19 (SCL), U5.19 (SCL), U6.19 (SCL), U7.19 (SCL), U8.19 (SCL), U9.19 (SCL), U10.19 (SCL)
/I2C1_SDA: R108.2, R110.1, U4.20 (SDA), U5.20 (SDA), U6.20 (SDA), U7.20 (SDA), U8.20 (SDA), U9.20 (SDA), U10.20 (SDA)
/Load Cell/diff+A: J4.3, R69.2
/Load Cell/diff+B: J5.3, R67.2
/Load Cell/diff+C: J30.3, R71.2
/Load Cell/diff+D: J31.3, R73.2
/Load Cell/diff-A: J4.2, R68.2
/Load Cell/diff-B: J5.2, R66.2
/Load Cell/diff-C: J30.2, R70.2
/Load Cell/diff-D: J31.2, R72.2
/Load Cell/output_D: R81.1, U14.14 (OUTD)
/Pressure 1/diff+A: J11.2, R82.2
/Pressure 1/diff+B: J12.2, R83.2
/Pressure 1/diff+C: J13.2, R84.2
/Pressure 1/diff+D: J14.2, R85.2
/Pressure 2/diff+A: J6.2, R90.2
/Pressure 2/diff+B: J7.2, R91.2
/Pressure 2/diff+C: J8.2, R92.2
/Pressure 2/diff+D: J9.2, R93.2
/Pressure and Flow/diff+A: J15.2, R98.2
/Pressure and Flow/diff+B: J16.3, R99.2
/Pressure and Flow/diff+C: J17.3, R100.2
/SPARE_gen_purp_amp/diff+A: J19.2, R51.2
/SPARE_gen_purp_amp/diff+B: J20.2, R53.2
/SPARE_gen_purp_amp/diff+C: J21.2, R55.2
/SPARE_gen_purp_amp/diff+D: J22.2, R57.2
/SPARE_gen_purp_amp/diff-A: J19.1, R50.2
/SPARE_gen_purp_amp/diff-B: J20.1, R52.2
/SPARE_gen_purp_amp/diff-C: J21.1, R54.2
/SPARE_gen_purp_amp/diff-D: J22.1, R56.2
/SPARE_gen_purp_amp/output_A: R62.1, TP1.1, U15.1 (OUTA)
/SPARE_gen_purp_amp/output_B: R63.1, TP2.1, U15.7 (OUTB)
/SPARE_gen_purp_amp/output_C: R64.1, TP3.1, U15.8 (OUTC)
/SPARE_gen_purp_amp/output_D: R65.1, TP4.1, U15.14 (OUTD)
/SWCLK: J1.3, U3.A9 (PA14)
/SWDIO: J1.4, U3.A10 (PA13)
GND: C1.2, C2.2, C3.2, C6.2, C7.2, C8.2, C9.2, C10.2, C11.2, C12.1, C15.2, C16.2, C20.2, C21.2, C22.2, C25.2, C26.2, C27.1, C28.1, C29.2, J1.1, J2.2, J3.2, J4.4, J5.4, J10.2, J16.4, J17.4, J30.4, J31.4, R3.2, R4.2, R5.2, R6.2, R13.2, R15.2, R16.2, R20.2, R21.2, R22.2, R23.2, R30.2, R32.2, R33.2, R36.2, R37.2, R38.2, R39.2, R46.2, R47.2, R58.2, R59.2, R60.2, R61.2, R74.2, R75.2, R76.2, R77.2, R86.2, R87.2, R88.2, R89.2, R94.2, R95.2, R96.2, R97.2, R102.2, R103.2, R104.2, R111.2, SW1.1, SW1.3, U1.2 (GND), U2.2 (GND), U2.8 (STBY), U3.C2 (VSS_5), U3.E4 (VSS_4), U3.E5 (VSS_3), U3.E6 (VSS_2), U3.E7 (VSS_1), U3.G1 (VSSA), U3.H1 (VREF-), U4.1 (GND), U4.3 (GND), U4.5 (GND), U4.10 (GND), U4.13 (GND), U4.16 (ADDR), U4.17 (GND), U4.18 (GND), U4.21 (Body_(gnd)), U5.1 (GND), U5.3 (GND), U5.5 (GND), U5.10 (GND), U5.13 (GND), U5.17 (GND), U5.18 (GND), U5.21 (Body_(gnd)), U6.1 (GND), U6.3 (GND), U6.5 (GND), U6.10 (GND), U6.13 (GND), U6.17 (GND), U6.18 (GND), U6.21 (Body_(gnd)), U7.1 (GND), U7.3 (GND), U7.5 (GND), U7.10 (GND), U7.13 (GND), U7.17 (GND), U7.18 (GND), U7.21 (Body_(gnd)), U8.1 (GND), U8.3 (GND), U8.5 (GND), U8.10 (GND), U8.13 (GND), U8.17 (GND), U8.18 (GND), U8.21 (Body_(gnd)), U9.1 (GND), U9.3 (GND), U9.5 (GND), U9.10 (GND), U9.13 (GND), U9.17 (GND), U9.18 (GND), U9.21 (Body_(gnd)), U10.1 (GND), U10.3 (GND), U10.5 (GND), U10.10 (GND), U10.13 (GND), U10.17 (GND), U10.18 (GND), U10.21 (Body_(gnd)), U11.11 (VSS), U12.11 (VSS), U13.11 (VSS), U14.11 (VSS), U15.11 (VSS), Y1.1, Y1.3
unnamed: C2.1, U1.4 (BYP)
unnamed: C12.2, U3.C1 (OSC_IN), Y1.2
unnamed: C13.1, R9.2, U4.2 (VIN+)
unnamed: C13.2, R10.2, U4.4 (VIN-)
unnamed: C14.1, R11.2, U5.2 (VIN+)
unnamed: C14.2, R12.2, U5.4 (VIN-)
unnamed: C17.1, R18.2, U6.2 (VIN+)
unnamed: C17.2, R19.2, U6.4 (VIN-)
unnamed: C18.1, R26.2, U7.2 (VIN+)
unnamed: C18.2, R27.2, U7.4 (VIN-)
unnamed: C19.1, R28.2, U8.2 (VIN+)
unnamed: C19.2, R29.2, U8.4 (VIN-)
unnamed: C23.1, R42.2, U9.2 (VIN+)
unnamed: C23.2, R43.2, U9.4 (VIN-)
unnamed: C24.1, R44.2, U10.2 (VIN+)
unnamed: C24.2, R45.2, U10.4 (VIN-)
unnamed: C27.2, R112.1, Y1.4
unnamed: C28.2, SW1.2, SW1.4, U3.E1 (NRST)
unnamed: J18.1, U2.7 (CANH)
unnamed: J18.2, U2.6 (CANL)
unnamed: J23.1, R3.1, R7.2, R9.1, U4.6 (VSENSE)
unnamed: J23.2, R5.1, R10.1
unnamed: J24.1, R4.1, R8.2, R11.1, U5.6 (VSENSE)
unnamed: J24.2, R6.1, R12.1
unnamed: J25.1, R15.1, R17.2, R18.1, U6.6 (VSENSE)
unnamed: J25.2, R16.1, R19.1
unnamed: J26.1, R20.1, R24.2, R26.1, U7.6 (VSENSE)
unnamed: J26.2, R22.1, R27.1
unnamed: J27.1, R21.1, R25.2, R28.1, U8.6 (VSENSE)
unnamed: J27.2, R23.1, R29.1
unnamed: J28.1, R36.1, R40.2, R42.1, U9.6 (VSENSE)
unnamed: J28.2, R38.1, R43.1
unnamed: J29.1, R37.1, R41.2, R44.1, U10.6 (VSENSE)
unnamed: J29.2, R39.1, R45.1
unnamed: R13.1, R14.1, U5.16 (ADDR)
unnamed: R30.1, R31.1, U6.16 (ADDR)
unnamed: R32.1, R34.1, U7.16 (ADDR)
unnamed: R33.1, R35.1, U8.16 (ADDR)
unnamed: R46.1, R48.1, U9.16 (ADDR)
unnamed: R47.1, R49.1, U10.16 (ADDR)
unnamed: R50.1, R62.2, U15.2 (INA-)
unnamed: R51.1, R58.1, U15.3 (INA+)
unnamed: R52.1, R63.2, U15.6 (INB-)
unnamed: R53.1, R59.1, U15.5 (INB+)
unnamed: R54.1, R64.2, U15.9 (INC-)
unnamed: R55.1, R60.1, U15.10 (INC+)
unnamed: R56.1, R65.2, U15.13 (IND-)
unnamed: R57.1, R61.1, U15.12 (IND+)
unnamed: R66.1, R79.2, U14.6 (INB-)
unnamed: R67.1, R74.1, U14.5 (INB+)
unnamed: R68.1, R78.2, U14.2 (INA-)
unnamed: R69.1, R76.1, U14.3 (INA+)
unnamed: R70.1, R80.2, U14.9 (INC-)
unnamed: R71.1, R75.1, U14.10 (INC+)
unnamed: R72.1, R81.2, U14.13 (IND-)
unnamed: R73.1, R77.1, U14.12 (IND+)
unnamed: R82.1, R86.1, U13.3 (INA+)
unnamed: R83.1, R87.1, U13.5 (INB+)
unnamed: R84.1, R88.1, U13.10 (INC+)
unnamed: R85.1, R89.1, U13.12 (IND+)
unnamed: R90.1, R94.1, U12.3 (INA+)
unnamed: R91.1, R95.1, U12.5 (INB+)
unnamed: R92.1, R96.1, U12.10 (INC+)
unnamed: R93.1, R97.1, U12.12 (IND+)
unnamed: R100.1, R104.1, U11.10 (INC+)
unnamed: R98.1, R102.1, U11.3 (INA+)
unnamed: R99.1, R103.1, U11.5 (INB+)
unnamed: R109.2, U3.B5 (PB6)
unnamed: R110.2, U3.A5 (PB7)
unnamed: R111.1, U3.D5 (BOOT0)
unnamed: R112.2, U3.D1 (OSC_OUT)
VDDA: C8.1, L1.1, U3.J1 (VREF+), U3.K1 (VDDA)
