SEDS-PSU/avionics/electronics/output-board/output-board.kicad_pcb

## KiCad design electronics/output-board/output-board.kicad_pcb (2022-04-03)

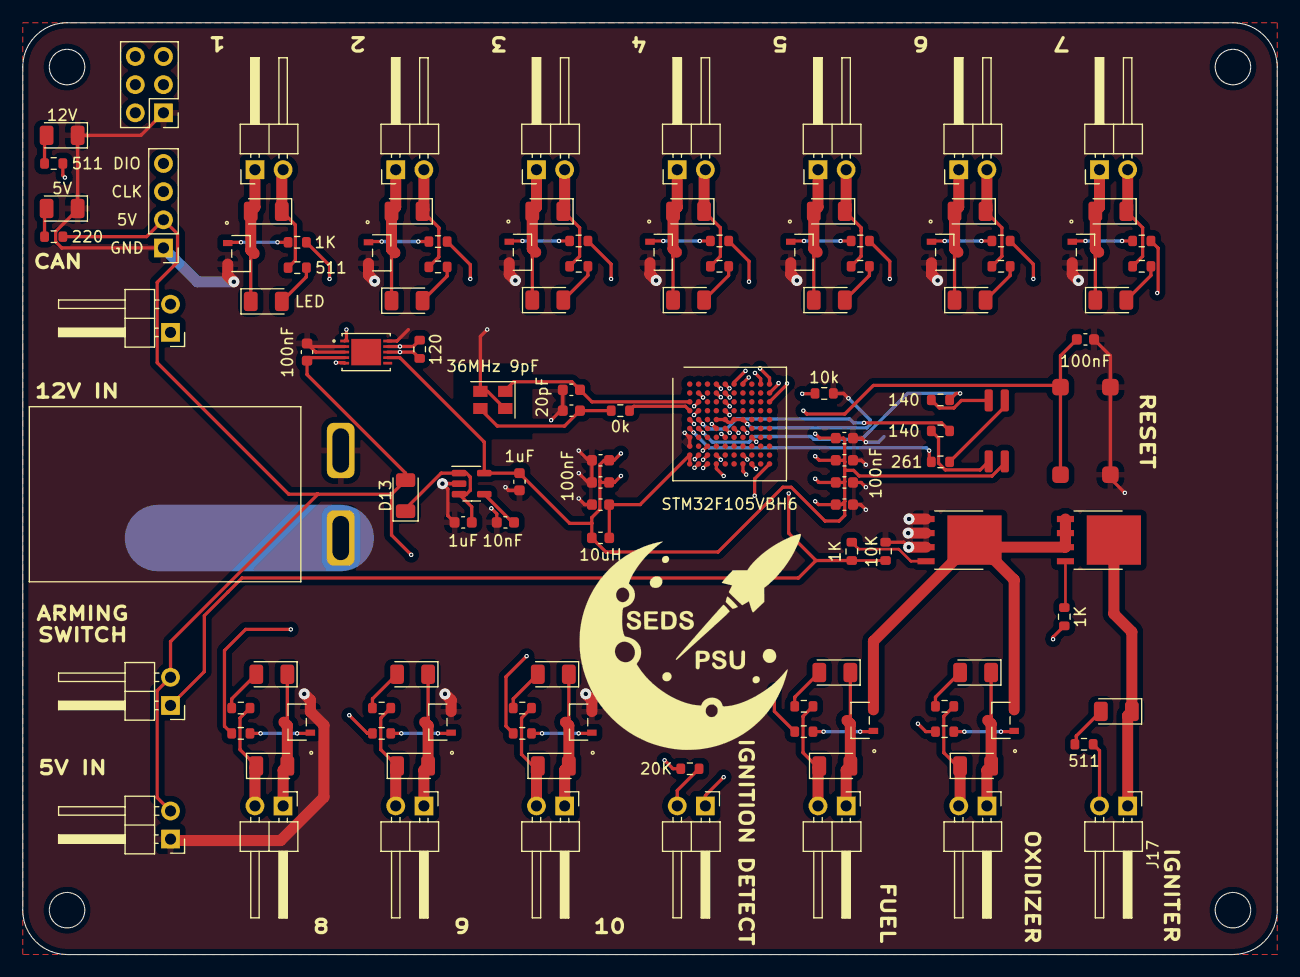
[picture p10: board output-board.kicad_pcb from above]

Board: 4 copper layers, 113.2 x 84.1 mm, 125 parts (0 on the bottom side), 88 nets.

Parts:
C1, C3: 1uF; C_0603_1608Metric
C2: 10nF; C_0603_1608Metric
C4, C5, C6, C7, C8, C9, C12, C13, C14: 100nF; C_0603_1608Metric
C10, C11: 20pF; C_0603_1608Metric
D1, D2, D3, D4, D5, D6, D7, D8, D9, D10, D11, D12, D16: LED; LED_1206_3216Metric
D13, D17, D18, D19, D20, D21, D22, D23, D24, D25, D26, D27, D28: 1N4007; D_1206_3216Metric
D14: 12V; LED_1206_3216Metric
D15: 5V; LED_1206_3216Metric
D29: LED_RGBA; RGB LED
HOLE1, HOLE1#2, HOLE1#3, HOLE1#4: MountingHole_3.2mm_M3
J1, J2, J7, J8, J9, J10, J11, J12, J13, J15, J16, J17, J18: Conn_01x02_Male; LatchingConnector2POS
J3: 12V In; PowerPoleThroughHole
J4, J6: Conn_01x02; LatchingConnector2POS
J5: SWD Header; PinHeader_1x04_P2.54mm_Vertical
J14: Arming switch; LatchingConnector2POS
J19: Extra IO; PinHeader_2x03_P2.54mm_Vertical
J20: Ignition Detector; LatchingConnector2POS
L1: 10uH; L_0603_1608Metric
MOSFET1, MOSFET2, MOSFET3, MOSFET4, MOSFET5, MOSFET6, MOSFET7, MOSFET8, MOSFET9, MOSFET11, MOSFET12, MOSFET18: BSS806NEH6327XTSA1
MOSFET10, MOSFET13: BUK9Y21-40E
R1: 10k; R_0603_1608Metric
R2, R4, R5, R6, R7, R8, R9, R10, R11, R20, R26, R28, R30, R31: 511; R_0603_1608Metric
R3: 0k; R_0603_1608Metric
R12, R14, R15, R16, R17, R18, R19, R21, R22, R23, R24, R25, R27, R29: 1K; R_0603_1608Metric
R13: 10K; R_0603_1608Metric
R32: 220; R_0603_1608Metric
R33: 261; R_0603_1608Metric
R34, R35: 140; R_0603_1608Metric
R36: 120; R_0603_1608Metric
R37: 20K; R_0603_1608Metric
Ref**: Val**; seds-logo
SW1: SW_Push_Dual; Button CS1102
U1: MAX33014EATB+; MAX33014EATB&plus_
U2: LD3985M33R_SOT23; SOT-23-5
U3: STM32F105VBH6; LFBGA-100_10x10mm_Layout10x10_P0.8mm
Y1: 36MHz 9pF; Crystal_SMD_3225-4Pin_3.2x2.5mm

Connections:
+3V3: C3.1, C4.1, C5.1, C8.1, C9.1, C12.1, C13.1, D29.4 (A), L1.2, U1.7 (VL), U2.5 (VOUT), U3.B2 (VBAT), U3.D2 (VDD_5), U3.F4 (VDD_4), U3.F5 (VDD_3), U3.F6 (VDD_2), U3.F7 (VDD_1)
+5V: C14.1, D13.2 (A), J4.2, J5.2, J14.2, R32.1, R37.2, U1.4 (VDD)
+12V: D17.1 (K), D18.1 (K), D19.1 (K), D20.1 (K), D21.1 (K), D22.1 (K), D23.1 (K), D24.1 (K), D25.1 (K), D26.1 (K), D27.1 (K), D28.1 (K), J1.2, J2.2, J3.2, J7.2, J8.2, J9.2, J10.2, J11.2, J12.2, J13.2, J15.2, J16.2, J17.2, J18.2, R2.1, R4.1, R5.1, R6.1, R7.1, R8.1, R9.1, R10.1, R11.1, R20.1, R26.1, R28.1, R30.1, R31.1
/CAN_RX: U1.5 (RXD), U3.C10 (PA11)
/CAN_TX: U1.1 (TXD), U3.B10 (PA12)
/MOSFET-sheet1/INPUT: R15.1, U3.K4 (PB1)
/MOSFET-sheet2/INPUT: R16.1, U3.G5 (PB2)
/MOSFET-sheet3/INPUT: R17.1, U3.A7 (PB3)
/MOSFET-sheet4/INPUT: R18.1, U3.A6 (PB4)
/MOSFET-sheet5/INPUT: R19.1, U3.C5 (PB5)
/MOSFET-sheet6/INPUT: R21.1, U3.B5 (PB6)
/MOSFET-sheet7/INPUT: R22.1, U3.A5 (PB7)
/MOSFET-sheet8/INPUT: R23.1, U3.B4 (PB8)
/MOSFET-sheet9/INPUT: R24.1, U3.A4 (PB9)
/MOSFET-sheet10/GROUND: MOSFET10.5, MOSFET11.2, MOSFET12.2, MOSFET13.1, MOSFET13.2, MOSFET13.3
/MOSFET-sheet10/INPUT: R25.1, U3.J7 (PB10)
/MOSFET-sheet11/INPUT: R27.1, U3.K7 (PB11)
/MOSFET-sheet/INPUT: R14.1, U3.J4 (PB0)
/SWCLK: J5.3, U3.A9 (PA14)
/SWDIO: J5.4, U3.A10 (PA13)
GND: C1.2, C2.2, C3.2, C4.2, C5.2, C6.2, C7.2, C8.2, C9.2, C10.1, C11.1, C12.2, C13.2, C14.2, D14.1 (K), D15.1 (K), J3.1, J4.1, J5.1, J19.1, MOSFET1.2, MOSFET2.2, MOSFET3.2, MOSFET4.2, MOSFET5.2, MOSFET6.2, MOSFET7.2, MOSFET8.2, MOSFET9.2, MOSFET10.1, MOSFET10.2, MOSFET10.3, MOSFET18.2, R1.2, R13.2, SW1.2, SW1.4, U1.2 (LPBK), U1.3 (GND), U1.10 (STBY), U2.2 (GND), U3.C2 (VSS_5), U3.E4 (VSS_4), U3.E5 (VSS_3), U3.E6 (VSS_2), U3.E7 (VSS_1), U3.G1 (VSSA), U3.H1 (VREF-), Y1.2, Y1.4
unnamed: C1.1, D13.1 (K), U2.1 (VIN), U2.3 (INH)
unnamed: C2.1, U2.4 (BYP)
unnamed: C7.1, SW1.1, SW1.3, U3.E1 (NRST)
unnamed: C10.2, U3.C1 (OSC_IN), Y1.1
unnamed: C11.2, R3.1, Y1.3
unnamed: D1.1 (K), D18.2 (A), J1.1, MOSFET1.3
unnamed: D1.2 (A), R2.2
unnamed: D2.2 (A), R20.2
unnamed: D3.2 (A), R4.2
unnamed: D4.2 (A), R5.2
unnamed: D5.2 (A), R6.2
unnamed: D6.2 (A), R7.2
unnamed: D7.2 (A), R8.2
unnamed: D8.2 (A), R9.2
unnamed: D9.2 (A), R10.2
unnamed: D10.1 (K), D26.2 (A), J13.1, MOSFET9.3
unnamed: D10.2 (A), R11.2
unnamed: D11.1 (K), D27.2 (A), J15.1, MOSFET11.3
unnamed: D11.2 (A), R26.2
unnamed: D12.1 (K), D28.2 (A), J16.1, MOSFET12.3
unnamed: D12.2 (A), R28.2
unnamed: D14.2 (A), R31.2
unnamed: D15.2 (A), R32.2
unnamed: D16.1 (K), J17.1, MOSFET13.5
unnamed: D16.2 (A), R30.2
unnamed: D2.1 (K), D17.2 (A), J18.1, MOSFET18.3
unnamed: D3.1 (K), D19.2 (A), J2.1, MOSFET2.3
unnamed: D4.1 (K), D20.2 (A), J7.1, MOSFET3.3
unnamed: D5.1 (K), D21.2 (A), J8.1, MOSFET4.3
unnamed: D6.1 (K), D22.2 (A), J9.1, MOSFET5.3
unnamed: D7.1 (K), D23.2 (A), J10.1, MOSFET6.3
unnamed: D8.1 (K), D24.2 (A), J11.1, MOSFET7.3
unnamed: D9.1 (K), D25.2 (A), J12.1, MOSFET8.3
unnamed: D29.1 (RK), R33.2
unnamed: D29.2 (GK), R34.2
unnamed: D29.3 (BK), R35.2
unnamed: J6.1, R36.2, U1.9 (CANH)
unnamed: J6.2, R36.1, U1.8 (CANL)
unnamed: J14.1, R12.1, R13.1, U3.G8 (PB15)
unnamed: J19.2, U3.J2 (PA2)
unnamed: J19.3, U3.K2 (PA3)
unnamed: J19.4, U3.H3 (PA5)
unnamed: J19.5, U3.J3 (PA6)
unnamed: J19.6, U3.K3 (PA7)
unnamed: J20.1, U3.K10 (PD12)
unnamed: J20.2, R37.1
unnamed: MOSFET1.1, R15.2
unnamed: MOSFET2.1, R16.2
unnamed: MOSFET3.1, R17.2
unnamed: MOSFET4.1, R18.2
unnamed: MOSFET5.1, R19.2
unnamed: MOSFET6.1, R21.2
unnamed: MOSFET7.1, R22.2
unnamed: MOSFET8.1, R23.2
unnamed: MOSFET9.1, R24.2
unnamed: MOSFET10.4, R12.2
unnamed: MOSFET11.1, R25.2
unnamed: MOSFET12.1, R27.2
unnamed: MOSFET13.4, R29.2
unnamed: MOSFET18.1, R14.2
unnamed: R1.1, U3.D5 (BOOT0)
unnamed: R3.2, U3.D1 (OSC_OUT)
unnamed: R29.1, U3.K8 (PB12)
unnamed: R33.1, U3.F1 (PC0)
unnamed: R34.1, U3.F2 (PC1)
unnamed: R35.1, U3.E2 (PC2)
VDDA: C6.1, L1.1, U3.J1 (VREF+), U3.K1 (VDDA)
