SEDS-PSU/avionics/software/pi-controller-demo/can-receiver/src/ioprio.h

#include <unistd.h>
#include <sys/syscall.h>

// The following definitions were copied from https://github.com/karelzak/util-linux/blob/master/schedutils/ionice.c,
// since Linux/glibc does not have a userland header with these constants/functions.

enum {
	IOPRIO_CLASS_NONE,
	IOPRIO_CLASS_RT,
	IOPRIO_CLASS_BE,
	IOPRIO_CLASS_IDLE,
};

enum {
	IOPRIO_WHO_PROCESS = 1,
	IOPRIO_WHO_PGRP,
	IOPRIO_WHO_USER,
};

#define IOPRIO_CLASS_SHIFT	(13)
#define IOPRIO_PRIO_MASK	((1UL << IOPRIO_CLASS_SHIFT) - 1)

#define IOPRIO_PRIO_CLASS(mask)	((mask) >> IOPRIO_CLASS_SHIFT)
#define IOPRIO_PRIO_DATA(mask)	((mask) & IOPRIO_PRIO_MASK)
#define IOPRIO_PRIO_VALUE(class, data)	(((class) << IOPRIO_CLASS_SHIFT) | data)

static inline int ioprio_set(int which, int who, int ioprio)
{
	return syscall(SYS_ioprio_set, which, who, ioprio);
}

static inline int ioprio_get(int which, int who)
{
	return syscall(SYS_ioprio_get, which, who);
}
