SEDS-PSU/avionics/(commit log)

2021-09-18 Add kicad projects
    [output-board.kicad_pcb, output-board.kicad_sch, raspi-hat.kicad_pcb, raspi-hat.kicad_sch, sensor-board.kicad_pcb, sensor-board.kicad_sch]
2021-09-18 Added title to sensor board
    [sensor-board.kicad_sch]
2021-09-18 Add MAX33012EASA+ component to electronics/libraries/
    [raspi-hat.kicad_sch]
2021-09-18 Added library for BSS806N MOSFET
2021-09-18 Added ADC KiCAD library
2021-09-18 Added STM32 library
2021-09-18 Fixed library directory in sensor board schematic
2021-09-18 Add components necessary for raspi hat
    [raspi-hat.kicad_sch]
2021-09-18 Added libraries to sensor board pcb schematic
    [sensor-board.kicad_pcb, sensor-board.kicad_sch]
2021-09-18 Added BSS806N library to the output board
    [output-board.kicad_sch]
2021-09-18 Added libraries to sensor board schematics
2021-09-18 STM32 and ADC datasheets added
2021-09-18 started working on output board
    [output-board.kicad_sch]
2021-09-18 Add initial library for ADS114S08 ADC
2021-09-20 Add read function to ADS114S08 driver
2021-09-21 Moved stm32 datasheet in appropriate folder
    [sensor-board.kicad_sch]
2021-09-21 Schematic edit
    [sensor-board.kicad_pcb, sensor-board.kicad_sch]
2021-09-21 Add mcu-base
    [mcu-base.kicad_pcb, mcu-base.kicad_sch]
2021-09-21 Sensor board schematic modified
    [sensor-board.kicad_sch]
2021-09-21 Add regulator and CAN transceiver to mcu-base
    [mcu-base.kicad_sch, sensor-board.kicad_sch]
2021-09-21 Remove mcu-base hiearchical sheet from sensor-board
    [sensor-board.kicad_sch]
2021-09-21 Replaced sensor-board with nicholas' changes
    [sensor-board.kicad_sch]
2021-09-21 Put all analog outputs on a bus
    [mcu-base.kicad_sch]
2021-09-22 Add oscillators and some various stuff around the stm32 to the mcu-base
    [mcu-base.kicad_sch]
2021-09-23 Remove hiearchy from mcu-base
    [mcu-base.kicad_sch]
2021-09-28 Copied mcu-base schematic into sensor-board
    [sensor-board.kicad_sch]
2021-09-28 Added MOSFETS to the output board.
    [output-board.kicad_sch]
2021-10-05 Add sensor board starting code
2021-10-06 Added Op Amp Library to sensor-board
    [sensor-board.kicad_pcb, sensor-board.kicad_sch]
2021-10-12 added datasheet, modified sensor-board schematic
    [sensor-board.kicad_sch]
2021-10-12 edited sensor-board
    [op_amp_array_1.kicad_sch, sensor-board.kicad_sch]
2021-10-15 Switched Op Amps
    Added library files for both op amps (precision and general purpose)
    Couldn't find symbol library for gen-purp. op amp
    [op_amp_array_1.kicad_sch, sensor-board.kicad_pcb, sensor-board.kicad_sch]
2021-10-16 Custom MAX44252 symbol created
    [op_amp_array_1.kicad_sch, sensor-board.kicad_sch]
2021-10-16 sensor-board edit, base differential amp. laid out
    [op_amp_array_1.kicad_sch, sensor-board.kicad_sch]
2021-10-17 Finished Schematic and Started Routing the Output Board
    [output-board.kicad_pcb, output-board.kicad_sch, untitled.kicad_sch]
2021-10-19 Working on ouput board.
    Saving before using the replicate layout plugin.
    [output-board.kicad_sch, untitled.kicad_sch]
2021-10-19 sensor-board layout edit
    op amp subunits added
    [op_amp_array_2.kicad_sch, op_amp_array_3.kicad_sch, op_amp_array_4.kicad_sch, op_amp_array_5.kicad_sch, sensor-board.kicad_sch]
2021-10-25 sensor-board edit
    [op_amp_array_2.kicad_sch, op_amp_array_5.kicad_sch, op_amp_array_6_lmc6036.kicad_sch, sensor-board.kicad_sch]
2021-10-26 Output Board is basically done!
    [output-board.kicad_pcb, output-board.kicad_sch, untitled.kicad_sch]
2021-10-26 sensor-board edits
    Finalized pressure and flow sensor circuits.
    Reorganized schematics
    [lmc6036_pressure-flow_3.kicad_sch, lmc6036_pressure_1.kicad_sch, lmc6036_pressure_2.kicad_sch, max44252_loadcells_3.kicad_sch, max44252_thermocouple_1.kicad_sch, max44252_thermocouple_2.kicad_sch, op_amp_array_2.kicad_sch, op_amp_array_3.kicad_sch]
2021-11-03 added datasheets
    [sensor-board.kicad_sch]
2021-11-06 work on sensor-board
    added MCP960 footprint
    finished MCP960 array schematic
    [MCP96RL01T_array_thermo.kicad_sch, lmc6036_pressure-flow_3.kicad_sch, lmc6036_pressure_1.kicad_sch, lmc6036_pressure_2.kicad_sch, max44252_loadcells.kicad_sch, max44252_loadcells_3.kicad_sch, max44252_thermocouple_1.kicad_sch, sensor-board.kicad_sch]
2021-11-06 work on sensor-board
    thermocouple connector footprints made (selected connector)
    [MCP96RL01T_array_thermo.kicad_sch, sensor-board.kicad_pcb, sensor-board.kicad_sch]
2021-11-06 Finish adding documentation o the rtic sensor-board example.
2021-11-09 Put in connectors and finalized layout of everything except MCU.
    [mcu-base.kicad_sch, output-board.kicad_pcb, output-board.kicad_sch, untitled.kicad_sch]
2021-11-10 work on sensor-board
    finishing sub-circuits
    switching mcu to stm32f105
    [MCP96RL01T_array_thermo.kicad_sch, max44252_loadcells.kicad_sch, sensor-board.kicad_sch]
2021-11-10 Finalized sensor-board schematic
    [MCP96RL01T_array_thermo.kicad_sch, lmc6036_pressure-flow_3.kicad_sch, lmc6036_pressure_2.kicad_sch, lmc6036_pressure_SPARE.kicad_sch, max44252_loadcells.kicad_sch, sensor-board.kicad_pcb, sensor-board.kicad_sch]
2021-11-10 Updated MCU Base and started MCU on Output Board
    [mcu-base.kicad_sch, output-board.kicad_pcb, output-board.kicad_sch, untitled.kicad_sch]
2021-11-16 Add MYSGK02506BRSR and start adding MYMGA5R04RELA5RA to Raspi HAT
    [24V_to_12V.kicad_sch, raspi-hat.kicad_sch]
2021-11-16 Continued Laying Out Output Board
    [output-board.kicad_pcb, output-board.kicad_sch, untitled.kicad_sch]
2021-11-18 Finish adding MYMGA5R04RELA5RA
    [12V_to_5V.kicad_sch, 24V_to_12V.kicad_sch, raspi-hat.kicad_sch]
2021-11-18 continued working on four-layer output board
    [output-board.kicad_pcb, output-board.kicad_sch, untitled.kicad_sch]
2021-11-18 Working on Output Board
2021-11-22 finished (mostly) output board
    [output-board.kicad_pcb, output-board.kicad_sch]
2021-11-25 Start laying out PCB for raspberry pi hat
    [12V_to_5V.kicad_sch, 24V_to_12V.kicad_sch, raspi-hat.kicad_pcb, raspi-hat.kicad_sch]
2021-11-27 work on sensor-board
    [lmc6036_pressure-flow_3.kicad_sch, lmc6036_pressure_1.kicad_sch, lmc6036_pressure_2.kicad_sch, lmc6036_pressure_SPARE.kicad_sch, max44252_loadcells.kicad_sch, sensor-board.kicad_pcb, sensor-board.kicad_sch]
2021-11-28 work on sensor-board pcb
    [sensor-board.kicad_pcb, sensor-board.kicad_sch]
2021-11-28 Minor routing changes
    [output-board.kicad_pcb]
2021-12-01 minor changes to output board
    [output-board.kicad_pcb, output-board.kicad_sch]
2021-12-02 added power leds and ignition detection
    [output-board.kicad_pcb, output-board.kicad_sch, untitled.kicad_sch]
2022-01-02 Finish designing raspi hat
    [12V_to_5V.kicad_sch, raspi-hat.kicad_pcb, raspi-hat.kicad_sch]
2022-01-02 Add SEDS logo to raspberry pi hat
    [raspi-hat.kicad_pcb]
2022-01-02 Fix footprint paths and add SEDS logo to output board
    [output-board.kicad_pcb]
2022-01-02 Add SEDS logo to sensor board
    [sensor-board.kicad_pcb]
2022-01-09 Add filled backplane to raspberry pi hat
    [raspi-hat.kicad_pcb]
2022-01-11 Finished sensor-board
    [sensor-board.kicad_pcb, sensor-board.kicad_sch]
2022-01-11 Edit to sensor-board
    [sensor-board.kicad_pcb]
2022-01-13 Boards sent off to get fabricated
    [output-board-B_Cu.gbr, output-board-B_Mask.gbr, output-board-B_Paste.gbr, output-board-B_Silkscreen.gbr, output-board-Edge_Cuts.gbr, output-board-F_Cu.gbr, output-board-F_Mask.gbr, output-board-F_Paste.gbr]
2022-01-13 Increase the size of a couple of vias on the output board
    [output-board-B_Cu.gbr, output-board-B_Mask.gbr, output-board-B_Paste.gbr, output-board-B_Silkscreen.gbr, output-board-Edge_Cuts.gbr, output-board-F_Cu.gbr, output-board-F_Mask.gbr, output-board-F_Paste.gbr]
2022-01-19 Created BOM
    [sensor-board BOM.xlsx]
2022-01-19 added thermocouple connector link
    [sensor-board BOM.xlsx]
2022-01-19 Add sensor-board boilerplate and set-up code
2022-01-19 Update shared to match the decided communication protocols between raspberry pi and boards
2022-01-19 BOM update
    [sensor-board BOM.xlsx]
2022-01-19 Create output-board BOM.xlsx
    [output-board BOM.xlsx]
2022-01-20 Add all sensors to shared crate
2022-01-21 Output board additions
2022-01-21 Do a lot more work on communications for the output board
2022-01-21 Fix incorrect queue length
    [main.rs]
2022-01-23 testing bash git
    [sensor-board BOM.xlsx]
2022-01-24 Do a bunch more work on the output-board software
2022-01-27 Get output board software much closer to ready
2022-01-29 Add sensor names to shared library
2022-01-29 Output board code is ready for testing
2022-01-31 Add initial driver implementation for the MCP96X thermocouple ICs
2022-01-31 Get sensor board software into a state from which testing can begin
2022-01-31 Change sensor type for load cells to Force
2022-02-07 Start getting I2C driver working
2022-02-07 Added test cases for output board
    [output-board.kicad_sch, untitled.kicad_sch]
2022-02-07 Attempt to get sensor board communicating with the thermocouple ICs
2022-02-21 resistor values fixed in sensor-board
2022-02-21 Start implementing valve sequences and valve sequence change commands for Pi controller demo
2022-02-21 Started updating the output board
    [output-board.kicad_pcb, output-board.kicad_sch, untitled.kicad_sch]
2022-02-24 Revising Output Board
    [output-board.kicad_pcb, output-board.kicad_sch, untitled.kicad_sch]
2022-02-24 More output board revisions
    [output-board.kicad_pcb]
2022-02-26 Implement proof-of-concept for sending valve sequence commands to the output board
2022-02-26 Start creating mock of output board
2022-02-27 Update raspi HAT schematic
    [raspi-hat.kicad_sch]
2022-02-28 Testing output board
2022-02-28 Add battery voltage reading to sensor board code
2022-03-01 Add some ground station comms stuff to the pi software
2022-03-03 Finishing touches on output board rev 2
    [output-board.kicad_pcb, output-board.kicad_sch]
2022-03-08 More work on sensor-board
    [lmc6036_pressure-flow_3.kicad_sch, lmc6036_pressure_1.kicad_sch, lmc6036_pressure_2.kicad_sch, max44252_loadcells.kicad_sch, sensor-board.kicad_pcb, sensor-board.kicad_sch]
2022-03-15 changed can transciever
    [output-board.kicad_pcb, output-board.kicad_sch]
2022-03-15 New transceiver on output board
    [output-board.kicad_pcb]
2022-03-19 Moved Diodes closer to connectors
    [output-board.kicad_pcb]
2022-03-20 Update Raspberry Pi HAT to Rev 2 requirements
    [raspi-hat.kicad_pcb, raspi-hat.kicad_sch]
2022-03-20 Re-add SEDS logo to Raspberry Pi HAT
    [raspi-hat.kicad_pcb]
2022-03-20 Updated CAN Transciever on sensor board
    [sensor-board.kicad_pcb, sensor-board.kicad_sch]
2022-03-20 Update HAT
    [raspi-hat.kicad_pcb, raspi-hat.kicad_sch]
2022-03-20 Fix unconnected items
    [raspi-hat.kicad_pcb]
2022-03-20 Fix DRC errors on Raspi HAT
    [raspi-hat.kicad_pcb, raspi-hat.kicad_sch]
2022-03-20 Fix battery voltage overflow bug
    [main.rs]
2022-03-21 updated loadcell amplifier
    [MCP96RL01T_array_thermo.kicad_sch, OLD DESIGN sensor-board.kicad_sch, lmc6036_pressure-flow_3.kicad_sch, lmc6036_pressure_1.kicad_sch, lmc6036_pressure_2.kicad_sch, lmc6036_pressure_SPARE.kicad_sch, max44252_loadcell1.kicad_sch, max44252_loadcell2.kicad_sch]
2022-03-23 almost final sensor-board pcb
    [sensor-board.kicad_pcb, sensor-board.kicad_sch]
2022-03-23 almost final sensor-board pcb 2
    [sensor-board.kicad_sch]
2022-03-23 more work on sensor-board pcb
    [sensor-board.kicad_pcb, sensor-board.kicad_sch]
2022-03-27 Hole Location File Added
    [sensor-board.kicad_pcb]
2022-03-27 Added Hole Location Schematic
2022-03-27 work on BOM file
    [sensor-board BOM OLD.xlsx, sensor-board.kicad_pcb]
2022-03-27 Added hole locations for output-board
    [output-board.kicad_pcb, sensor-board.kicad_pcb]
2022-03-30 updated bom excel file
2022-03-30 update on BOM
    [sensor-board.kicad_pcb, sensor-board.kicad_sch]
2022-04-13 res value fix
    [lmc6036_pressure-flow_3.kicad_sch, sensor-board.kicad_pcb, sensor-board.kicad_sch]
2022-04-16 Update embedded software for new board revisions
2022-04-16 Re-enable peripheral clock on sensor board
2022-04-16 Fix mcp96x temperature reading
    [lib.rs]
2022-04-16 Possibly fix temperature reading
    [lib.rs]
2022-04-16 Increase sampling time on sensor board ADCs
2022-04-16 Disable frame queue on sensor board
2022-04-16 Remove testsuite from sensor board
2022-04-17 remove core affinities and fix deadline scheduling
    [main.rs]
2022-04-19 Fix output board CAN peripheral frequency, hopefully
    [main.rs]
2022-04-20 Started work on board mount
    [makeProjectedPlanarWire.x_t, mounting.SLDPRT]
2022-04-20 The CAN bus works!
2022-04-21 Update output board software and the shared crate
2022-04-24 Get sensor board software updated
2022-04-25 Maybe get sensor board comms working
2022-05-01 Update code after cold-flow
2022-05-02 Instrument sensor board tasks
2022-05-03 Update for most recent sensor board changes
